camillebeland/design3/Rapport/tex/electronique.tex

\chapter{Schémas électroniques}

L'électronique est une partie importante du robot et il est important de planifier en détail les schémas électriques avant d'imprimer les PCBs. Il est a noter que le robot fonctionne avec une batterie, donc tous les symboles de mise à la terre des schémas du robots font en fait référence au 0V de la batterie.

\input{tex/electronique_alim.tex}
\input{tex/electronique_asservissement.tex}
\input{tex/electronique_induction.tex}
\input{tex/electronique_electroaimant.tex}
\input{tex/electronique_prehenseur.tex}
\input{tex/electronique_manschester.tex}
