camillebeland/design3/Rapport/tex/electronique_induction.tex

\section{Induction}

Le circuit représenté à la figure \ref{fig:induction} sert à induire un maximum de puissance au circuit de l'actionneur.
Un signal PWM est envoyé à partir du arduino de la station de base, ce dernier est amplifié par l'étage de puissance formé par les transistors.

\begin{figure}[ht]
  \centering
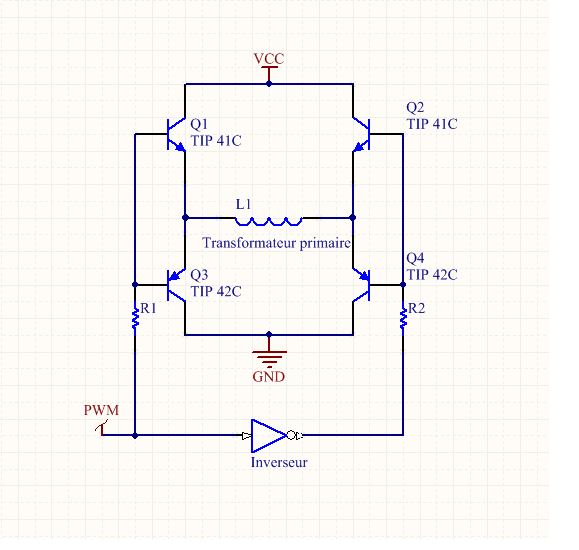
[picture p1: Rapport/resources/induction.png]
  
  \caption{Schéma électronique du circuit d'induction}
  \label{fig:induction}
\end{figure}
