camillebeland/design3/Rapport/tex/electronique_prehenseur.tex

\section{Préhenseur}

Un préhenseur est requis afin de soulever le trésor et l'amener à destination.
Afin d'économiser la charge du condensateur, il faut miniser le temps où l'électroaimant est allumé.
Il est donc optimal de soulever le trésor à l'horizontal, dans une position où il repose sur une surface plate.

Pour ce faire, le préhenseur est constitué d'un arbre entraîné par un servo-moteur contrôllé par le pololu,
comme on peut voir sur la figure \ref{fig:lift_down}.
L'électroaimant destiné à prendre le trésor est fixé au milieu de l'arbre.
Lorsqu'un trésor est pris par le préhenseur, il est soulevé puis basculé contre un muret de bois comme sur la figure \ref{fig:lift_up}.
Il est alors possible de conserver le trésor sans qu'aucune puissance ne soit consommée.

\begin{figure}[ht]
  \centering
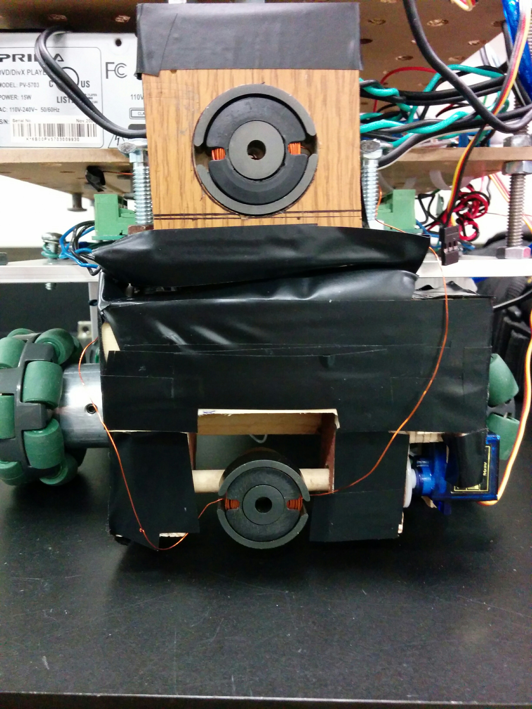
[picture p2: Rapport/resources/prehenseur_down.jpg]
  
  \caption{préhenseur en position de prise de trésor}
  \label{fig:lift_down}
\end{figure}

\begin{figure}[ht]
  \centering
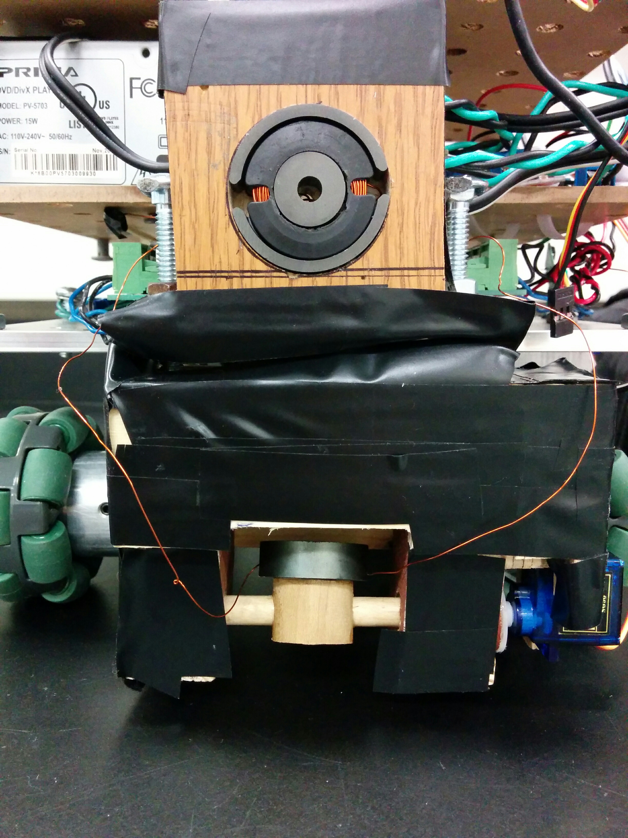
[picture p3: Rapport/resources/prehenseur_up.jpg]
  
  \caption{préhenseur en position de conservation du trésor}
  \label{fig:lift_up}
\end{figure}
