camillebeland/design3/Rapport/resources/diag_cont.pdf

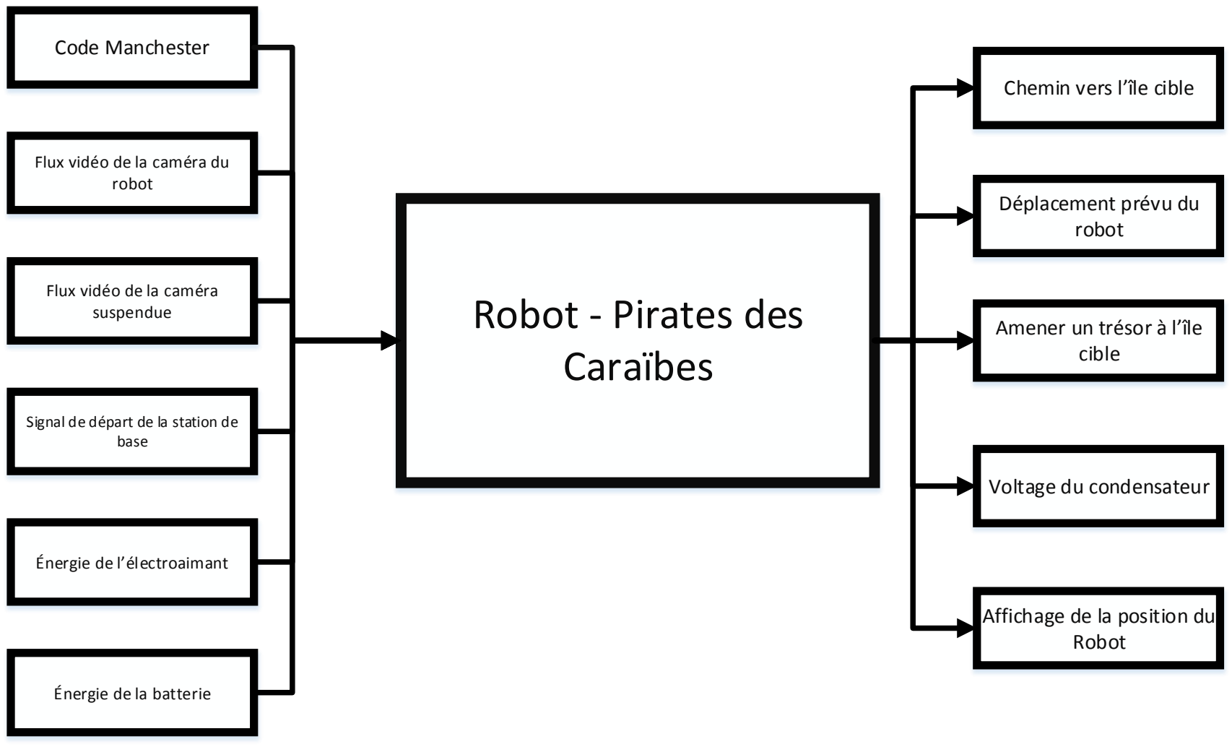
[picture p8: figure]
Robot - Pirates des Caraïbes; Code Manchester; Flux vidéo de la caméra du robot; Flux vidéo de la caméra suspendue; Signal de départ de la station de base; Énergie de l’électroaimant; Chemin vers l’île cible; Déplacement prévu du robot; Amener un trésor à l’île cible; Voltage du condensateur; Affichage de la position du Robot; Énergie de la batterie
