camillebeland/design3/Rapport/tex/bilan.tex

\chapter{Bilan post-mortem}
 
Lors d'un projet d'envergure comme celui de Design 3, il est important d'y jeter un regard en rétrospective et d'en retirer des leçons. Par exemple, déterminer les points forts et les points faibles permet de réfléchir sur les choix de design effectués au cours de la session et de s'améliorer en tant qu'ingénieur.
\input{tex/bilan_forts.tex}
\input{tex/bilan_amelioration.tex}
\input{tex/bilan_refaire.tex}
