camillebeland/design3/Rapport/tex/intro.tex

\chapter{Introduction}
Le présent rapport présente le quatrième et dernier livrable du projet Pirate des caraïbes pour le cours de Design III.
Le projet consiste à développer un robot autonome capable de repérer des pièces ferromagnétiques représentant des trésors,
de les ramasser et d'aller les déposer sur l'île spécifiée au début du défi. Plusieurs disciplines du génie sont requises afin d'accomplir la tâche,
il est donc important de bien identifier les requis et d'avoir une idée structurée du problème dès le départ. Ce rapport présente donc le résultat de la décomposition technique du problème.
Il s'agit donc d'un compte-rendu de ce qui a été fait durant toute la session et d'un compte-rendu du projet.
