camillebeland/design3/Rapport/tex/diagrams.tex

\chapter{Diagrammes Logiciel}
Les prochains diagrammes ont pour but de présenter notre architecture logicielle.
Le diagramme de classes offre une vue d'ensemble sur les différentes composantes de la partie logicielle du projet. 
Les diagrammes de séquences montrent comment les différentes composantes interagissent entre elles.
Les diagrammes de séquences sont divisés en plusieurs sous-tâches du défi afin d'améliorer la lisibilité.
Les interactions sont aussi limités au classes principales afin de permettre de comprendre facilement la séquence sans trop alourdir le schéma.

\begin{landscape}
\begin{figure}
  \centering
  
  \caption{Diagramme de classes}
\end{figure}

\begin{figure}
  \centering
  
  \caption{Diagramme de séquence complet}
\end{figure}

\begin{figure}
  \centering
  
  \caption{Diagramme de séquence de la boucle de sense-compute-control lors d'un déplacement}
\end{figure}

\begin{figure}
  \centering
  
  \caption{Diagramme de séquence de recharge}
\end{figure}

\begin{figure}
  \centering
  
  \caption{Diagramme de séquence de recherche de trésor}
\end{figure}

\begin{figure}
  \centering
  
  \caption{Diagramme de séquence dépot du trésor}
\end{figure}
\end{landscape}
