camillebeland/design3/Rapport/tex/DPF.tex

\chapter{Diagramme des propriétés fonctionelles}

\begin{landscape}
\begin{figure}[h]
  \centering
  \caption{DPF}
  
\end{figure}
\end{landscape}
