camillebeland/design3/Rapport/tex/plan_integration.tex

\chapter{Plan d'intégration}

L'intégration est une partie majeure du projet.
Elle consiste à assembler et à faire fonctionner les différents sous-systèmes entre eux.
Comme il y a beaucoup de sous-systèmes, l'intégration doit être effectuée de manière méthodique, en plusieurs étapes.
Il est important de faire un plan d'intégration assez tôt pour pouvoir guider l'équipe dans une intégration structurée.
Ce plan permet de séparer l'intégration en phases et en étapes, afin d'accélérer le processus et d'avoir un maximum de temps pour les tests.

\begin{landscape}
\begin{figure}
  \centering
  
  \caption{Plan d'intégration}
\end{figure}
\end{landscape}
