camillebeland/design3/Rapport/tex/annexe_dpf.tex

\begin{landscape}
  \begin{figure}[h]
    \label{annexe_dpf}
    \centering
    
    \caption{Description des propriétés fonctionnelles}
  \end{figure}
\end{landscape}
