camillebeland/design3/Rapport/resources/gantt.pdf

Untitled Gantt Project | 3 avr. 2016
Diagramme de Gantt | 7
Nom | Date de début | Date de fin
conception préliminaire de l'AI | 14/01/16 | 30/01/16
description des cas d'utilisation | 14/01/16 | 30/01/16
diagrammes de séquences 1ere itération 14/01/16 | 30/01/16
Diagramme de classe 1ere itération | 14/01/16 | 30/01/16
Réunion 1 | 18/01/16 | 18/01/16
Réunion 2 | 25/01/16 | 25/01/16
familiarisation avec l'équpement | 14/01/16 | 30/01/16
monter le robot | 14/01/16 | 30/01/16
choix du microcontrolleur | 14/01/16 | 25/01/16
tester les roues | 26/01/16 | 30/01/16
tester l'ordinateur | 14/01/16 | 30/01/16
tester les caméras | 14/01/16 | 30/01/16
analyse des alimentations nécéssaires | 14/01/16 | 25/01/16
choix et commande de la batterie | 26/01/16 | 30/01/16
Redaction du rapport | 14/01/16 | 30/01/16
redaction de la DPF | 14/01/16 | 30/01/16
redaction du diagramme de contexte | 14/01/16 | 30/01/16
remise 1 | 31/01/16 | 31/01/16
Réunion 3 | 08/02/16 | 08/02/16
Réunion 4 | 15/02/16 | 15/02/16
Réunion 5 | 22/02/16 | 22/02/16
conception et expérimentations | 20/01/16 | 20/03/16
construction de la station de recharge | 26/01/16 | 15/02/16
construction du chassis du robot | 21/01/16 | 31/01/16
construction du prehenseur | 21/01/16 | 08/02/16
commmunication entre l'ordinateur em...20/01/16 | 28/01/16
controler la caméra embarquée | 26/01/16 | 04/02/16
faire une librairie pour le control du...26/01/16 | 04/02/16
Detecter les élements du jeu | 02/02/16 | 07/03/16
Détecter la position et l'angle du ro... 02/02/16 | 22/02/16
placer des indicateurs sur le des...02/02/16 | 22/02/16
détecter en temps réel la positio...02/02/16 | 22/02/16
Détecter les îles | 02/02/16 | 04/03/16
Détecter les trésors | 05/02/16 | 03/03/16
Détecter la station de recharge | 16/02/16 | 07/03/16
Détecter les limites de la zone de jeu 02/02/16 | 04/03/16
Acquérir et décoder un code mansches... 02/02/16 | 13/03/16
acquérir le code manschester sans fil 02/02/16 | 17/02/16
utiliser des modules RF pour co... 02/02/16 | 17/02/16
Décoder le code manschester | 18/02/16 | 22/02/16
Faire une requête serveur | 23/02/16 | 13/03/16
Trouver et manipuler un trésor | 31/01/16 | 13/03/16
Charger l'électro-aimant | 31/01/16 | 17/02/16
Mesurer la tension dans le condens... 11/02/16 | 29/02/16
Soulever et déposer un trésor à l'aid...18/02/16 | 06/03/16
Choisir un trésor en fonction de sa ... 04/03/16 | 13/03/16
Alimenter le système | 24/01/16 | 23/02/16
Protéger les différents circuits | 24/01/16 | 23/02/16
Fournir l'alimentation approprié à c... 24/01/16 | 23/02/16
Déplacer le robot | 24/01/16 | 23/02/16
Asservir les déplacements en positi... 26/01/16 | 09/02/16
Déplacer le robot en ligne droite | 10/02/16 | 23/02/16
Effectuer une rotation du robot sur ...10/02/16 | 23/02/16
Déterminer un trajet entre deux poi... 24/01/16 | 23/02/16
Choisir automatiquement la prochaine ... 24/02/16 | 20/03/16
Être prêt au jeu après la mise sous t...24/02/16 | 20/03/16
Faire toutes les étapes du jeu sans i... 28/02/16 | 20/03/16
Afficher l'état du jeu | 24/02/16 | 13/03/16
afficher la tension du condensateur 01/03/16 | 13/03/16
afficher la carte virtuelle du jeu ave... 05/03/16 | 10/03/16
Afficher les déplacements du robot ...24/02/16 | 29/02/16
Préparation à la présentation orale | 21/02/16 | 24/02/16
présentations orales d'avancement | 25/02/16 | 25/02/16
Rapport 2 | 21/02/16 | 27/02/16
registre de risques | 21/02/16 | 27/02/16
Diagramme des fonctionnalités | 21/02/16 | 27/02/16
Diagramme physique | 21/02/16 | 27/02/16
Plan de test | 21/02/16 | 27/02/16
Diagramme de classes 2e itération | 21/02/16 | 27/02/16
Diagrammes de séquences 2e itération 21/02/16 | 27/02/16
développement logiciel | 21/02/16 | 27/02/16
tests unitaires | 21/02/16 | 27/02/16
Plan d'intégration | 21/02/16 | 27/02/16
Avancement de la construction système 21/02/16 | 27/02/16
remise 2 | 28/02/16 | 28/02/16
Réunion 6 | 29/02/16 | 29/02/16
Réunion 7 | 07/03/16 | 07/03/16
Réunion 8 | 14/03/16 | 14/03/16
Réunion 9 | 21/03/16 | 21/03/16
Réunion 10 | 28/03/16 | 28/03/16
Integration | 29/02/16 | 02/04/16
phase 1 | 29/02/16 | 03/03/16
phase 2 | 04/03/16 | 11/03/16
phase 3 | 12/03/16 | 18/03/16
phase 4 | 21/03/16 | 02/04/16
Tests selon la matrice de tests | 29/02/16 | 07/04/16
demonstrations | 31/03/16 | 31/03/16
Rapport 3 | 30/03/16 | 02/04/16
Registre de risques corrigé | 30/03/16 | 02/04/16
Diagramme de classes | 30/03/16 | 02/04/16
Diagrammes de séquence 3e itération | 30/03/16 | 02/04/16
Explication des algorithmes de vision ut...30/03/16 | 02/04/16
schémas électroniques | 30/03/16 | 02/04/16
Plan d'intégration corrigé | 30/03/16 | 02/04/16
DPF 3e itération | 30/03/16 | 02/04/16
remise 3 | 03/04/16 | 03/04/16
Temps de réserve pour terminer le robot | 02/04/16 | 07/04/16
Tests de robustesse finaux et raffinage | 08/04/16 | 13/04/16
Réunion 11 | 04/04/16 | 04/04/16
Réunion 12 | 11/04/16 | 11/04/16
competition | 14/04/16 | 14/04/16
remise 4 | 17/04/16 | 17/04/16

2016

Semaine 2 | Semaine 3 | Semaine 4 | Semaine 5 | Semaine 6 | Semaine 7 | Semaine 8 | Semaine 9 | Semaine 10 | Semaine 11 | Semaine 12 | Semaine 13 | Semaine 14 | Semaine 15 | Semaine 16
11/01/16 | 18/01/16 | 25/01/16 | 01/02/16 | 08/02/16 | 15/02/16 | 22/02/16 | 29/02/16 | 07/03/16 | 14/03/16 | 21/03/16 | 28/03/16 | 04/04/16 | 11/04/16 | 18/04/16
Réunion 1 Réunion 2 remise 1 | Réunion 3 Réunion 4 Réunion 5 présentations orales d'avancement remise 2 Réunion 6 Réunion 7 Réunion 8 Réunion 9 Réunion 10 demonstrations remise 3 Réunion 11 Réunion 12 competition remise 4
