camillebeland/design3/base_station/mock_image_worst_case.jpg

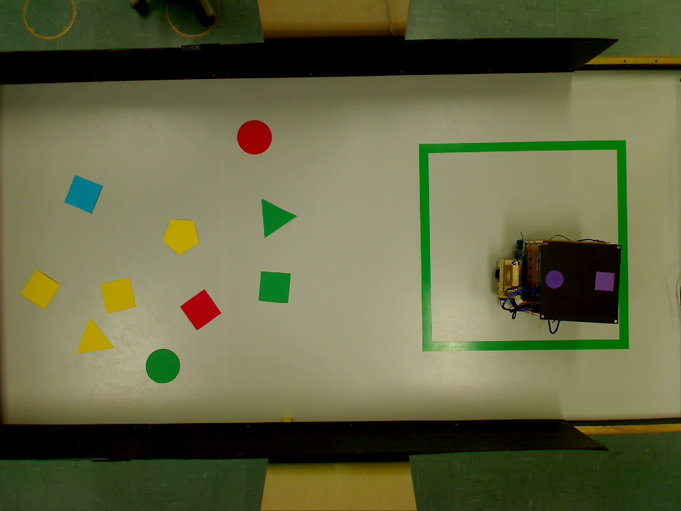
base_station/mock_image_worst_case.jpg
