camillebeland/design3/base_station/vision/mock_image.jpg

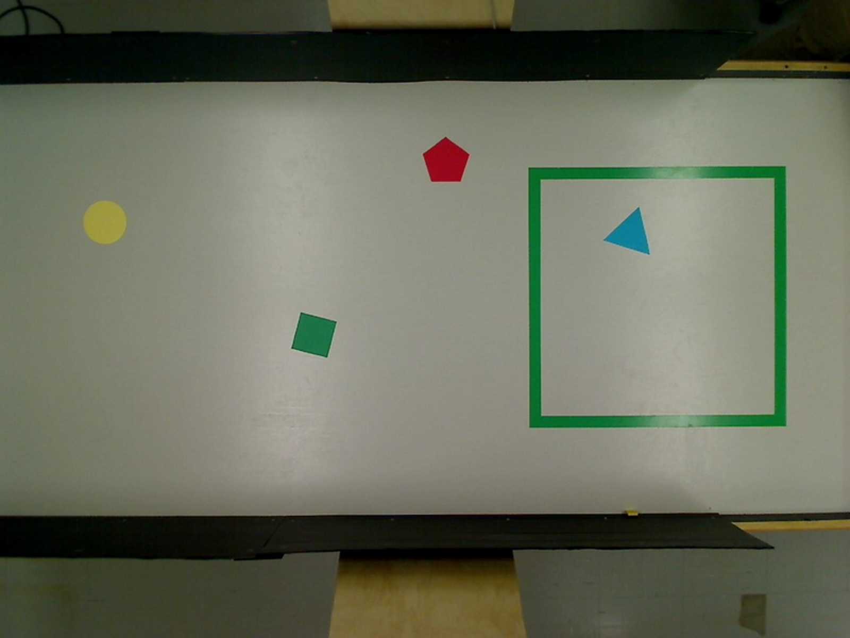
base_station/vision/mock_image.jpg
