camillebeland/design3/Rapport/resources/induction.jpg

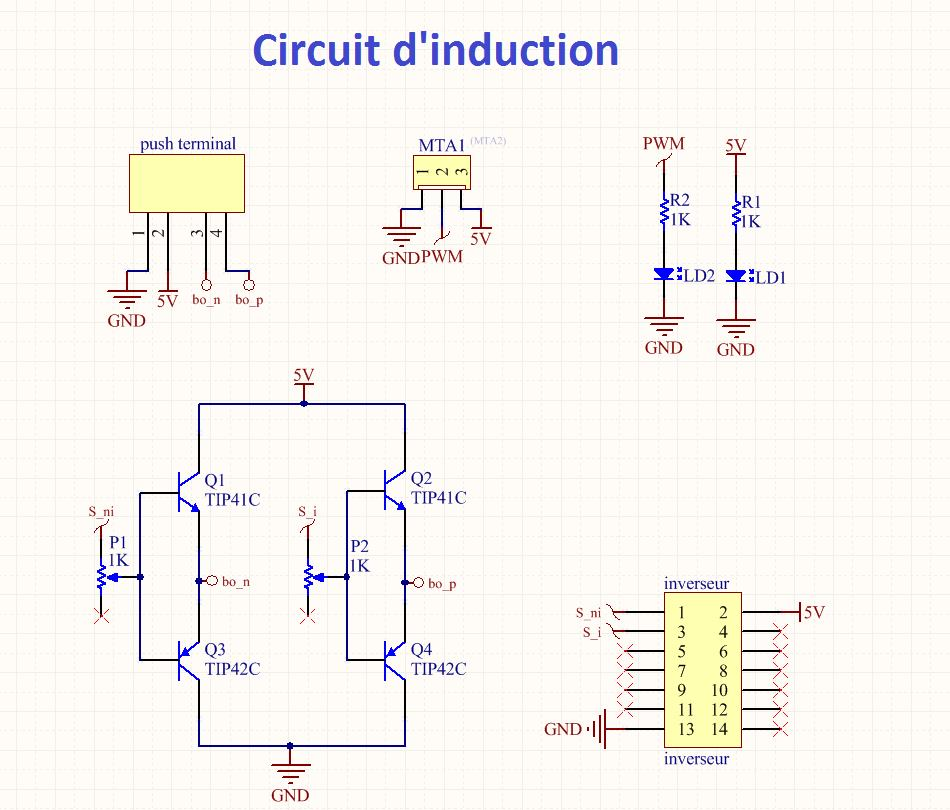
Rapport/resources/induction.jpg
