camillebeland/design3/Rapport/resources/regu_analog.jpg

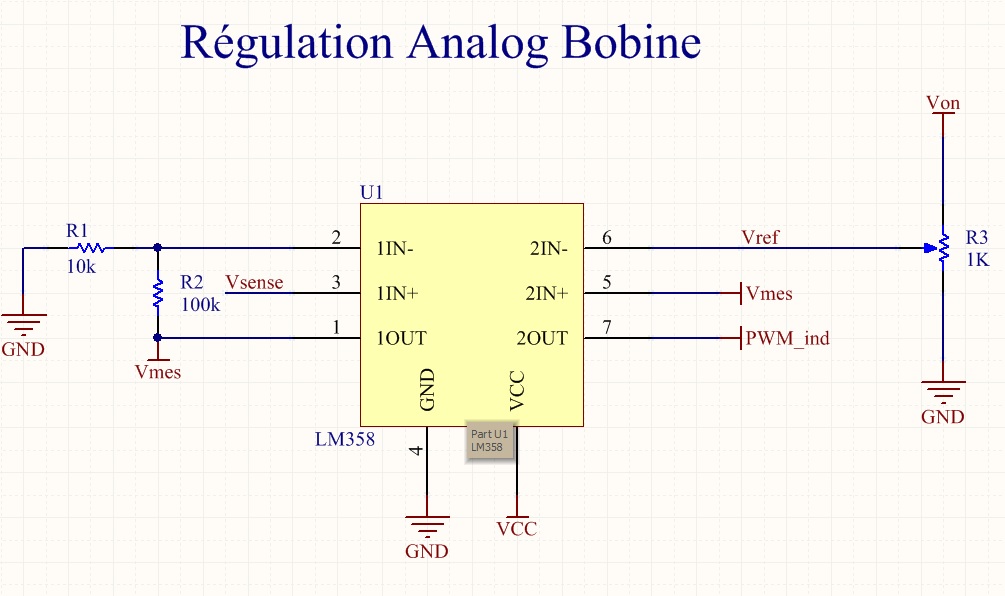
Rapport/resources/regu_analog.jpg
