camillebeland/design3/vision_utils/embedded_treasures.jpg

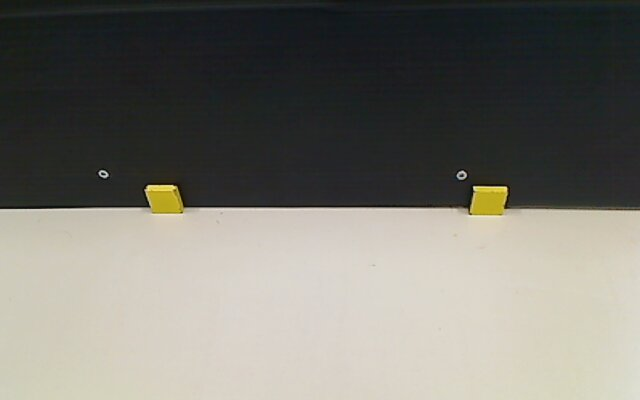
vision_utils/embedded_treasures.jpg
