camillebeland/design3/vision_utils/mock_image.jpg

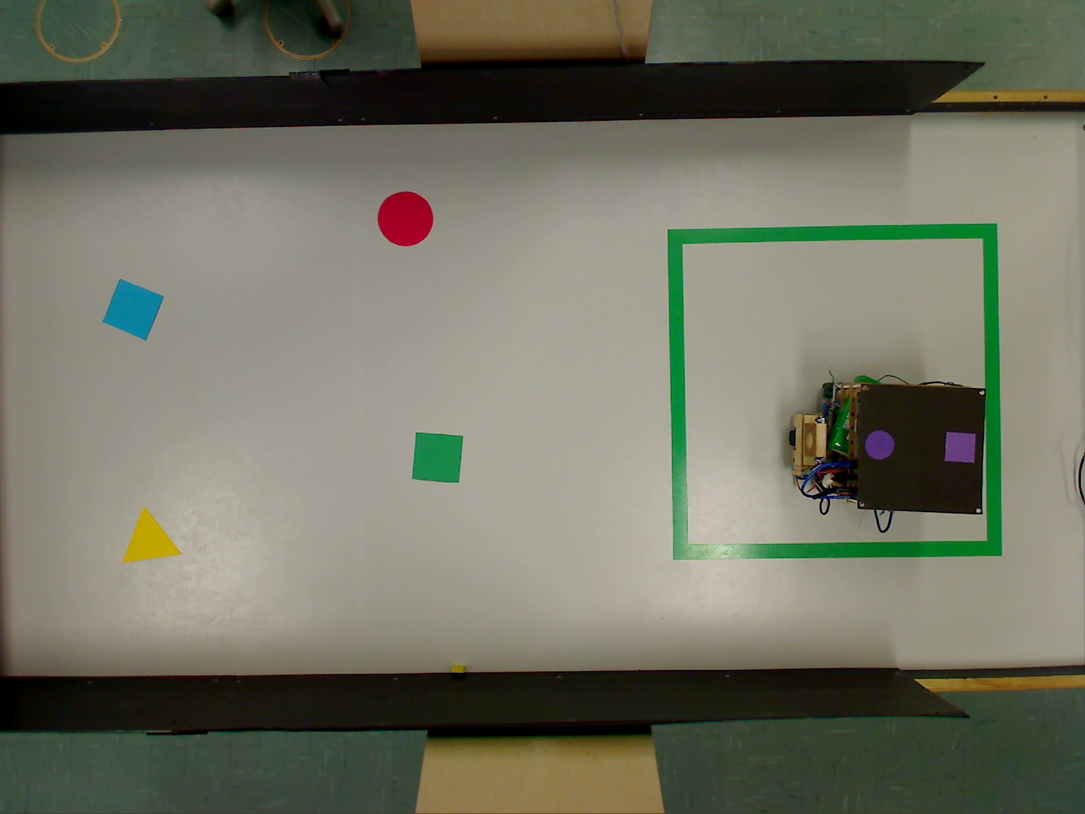
vision_utils/mock_image.jpg
