camillebeland/design3/vision_utils/photo_robot_mauve.jpg

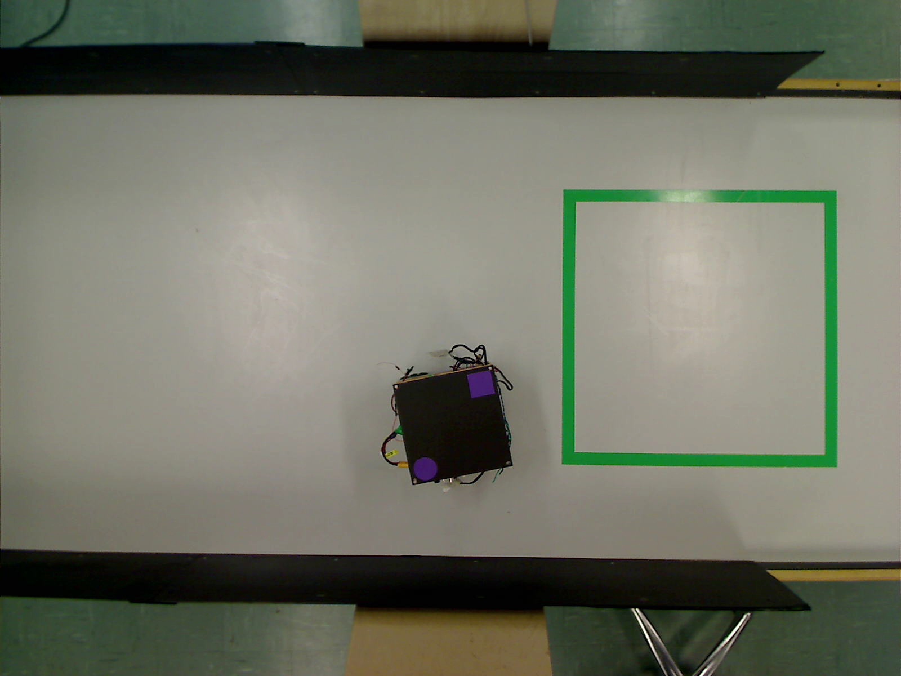
vision_utils/photo_robot_mauve.jpg
