camillebeland/design3/Rapport/tex/tests_unitaires.tex

\chapter{Tests unitaires}

Voir le code source.
Les test peuvent être exécutés à l'aide de nosetests.
Pour le coverage, utiliser la commande "nosetests --with-coverage"
