camillebeland/design3/Rapport/resources/alim.pdf

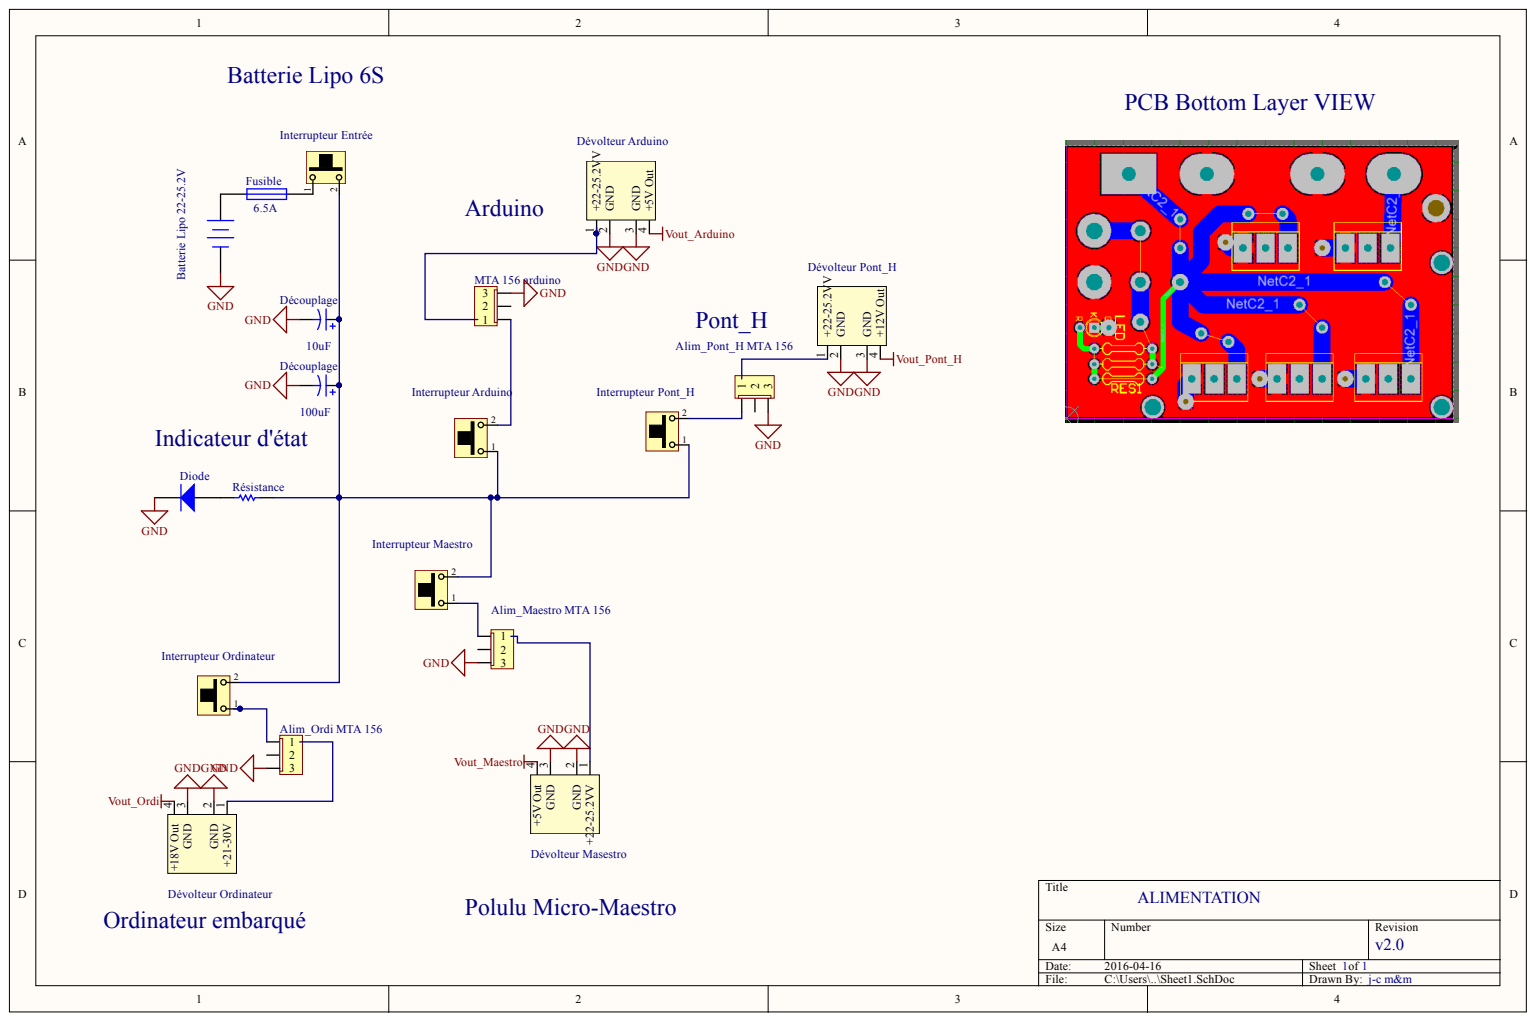
[picture p18: page 1]

PCB Bottom Layer VIEW

GND 3 +5V Out 4 Dévolteur Masestro

GND 3 +18V Out 4 Dévolteur Ordinateur
