camillebeland/design3/Rapport/resources/shield.pdf

SCL | 1 SDA | 2 RX1 | 3 TX 1 | 4 RX2 | 5 TX 2 | 6 RX3 | 7 TX 3 | 8
5v | 1 5v 2 | 22 | 3 23 4 | 24 | 5 25 6 | 26 | 7 27 8 | 28 | 9 29 10 | 30 | 11 31 12 | 32 | 13 33 14 | 34 | 15 35 16 | 36 | 17 37 18 | 38 | 19 39 20 | 40 | 21 41 22 | 42 | 23 43 24 | 44 | 25 45 26 | 46 | 27 47 28 | 48 | 29 49 30 | 50 | 31 51 32 | 52 | 33 53 34 | 0v | 35 0v 36

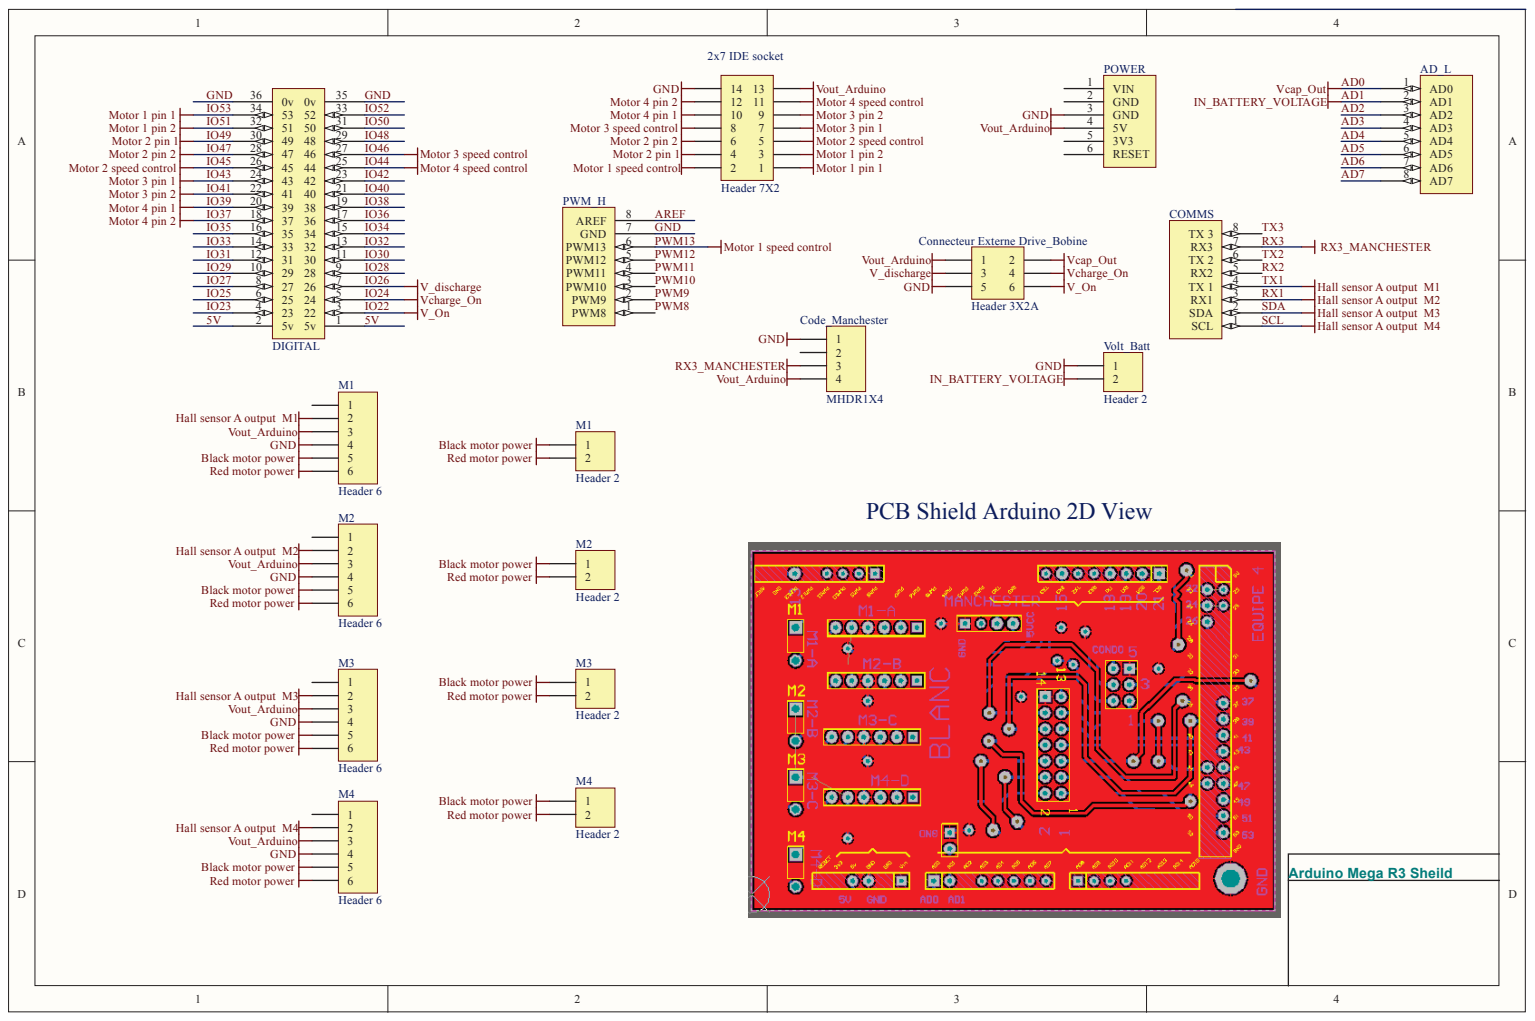
[picture p19: page 1]
PWM8; PWM9; PWM10; PWM11; PWM12; PWM13; GND; AREF; SDA SCL; VIN 1; GND 2; GND 3 5V 4 3V3 5 RESET 6; POWER; COMMS; 1 PWM9; 2 PWM10; 3 PWM11; 4 PWM12; 5 PWM13; 6 GND; 7 AREF; PWM_H; DIGITAL; 2x7 IDE socket; Header 7X2; Header 6; Header 2; Motor 2 pin 1; Motor 2 pin 2; Motor 4 pin 1; Motor 4 pin 2; Motor 1 pin 1 Motor 1 pin 2 Motor 2 pin 1 Motor 2 pin 2; Motor 3 pin 1 Motor 3 pin 2 Motor 4 pin 1 Motor 4 pin 2; Vout_Arduino; Connecteur Externe Drive_Bobine; Header 3X2A; Volt_Batt; Code_Manchester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

Vout_Arduino
Motor 4 speed control
Motor 3 pin 2
Motor 3 pin 1
Motor 2 speed control
Motor 1 pin 2
Motor 1 pin 1

Motor 3 speed control

Motor 1 speed control

Hall sensor A output M1
Hall sensor A output M2
Hall sensor A output M3
Hall sensor A output M4

Black motor power
Red motor power

PCB Shield Arduino 2D View

Arduino Mega R3 Sheild
