camillebeland/design3/Rapport/pdf/UL_P.pdf

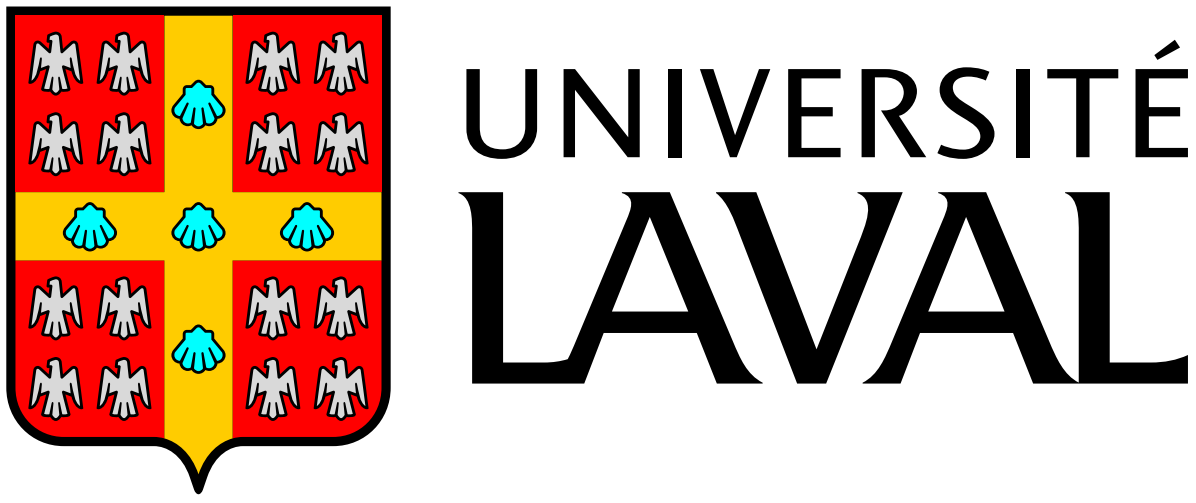
[picture p20: page 1]
