camillebeland/design3/Rapport/resources/diag_fonc.pdf

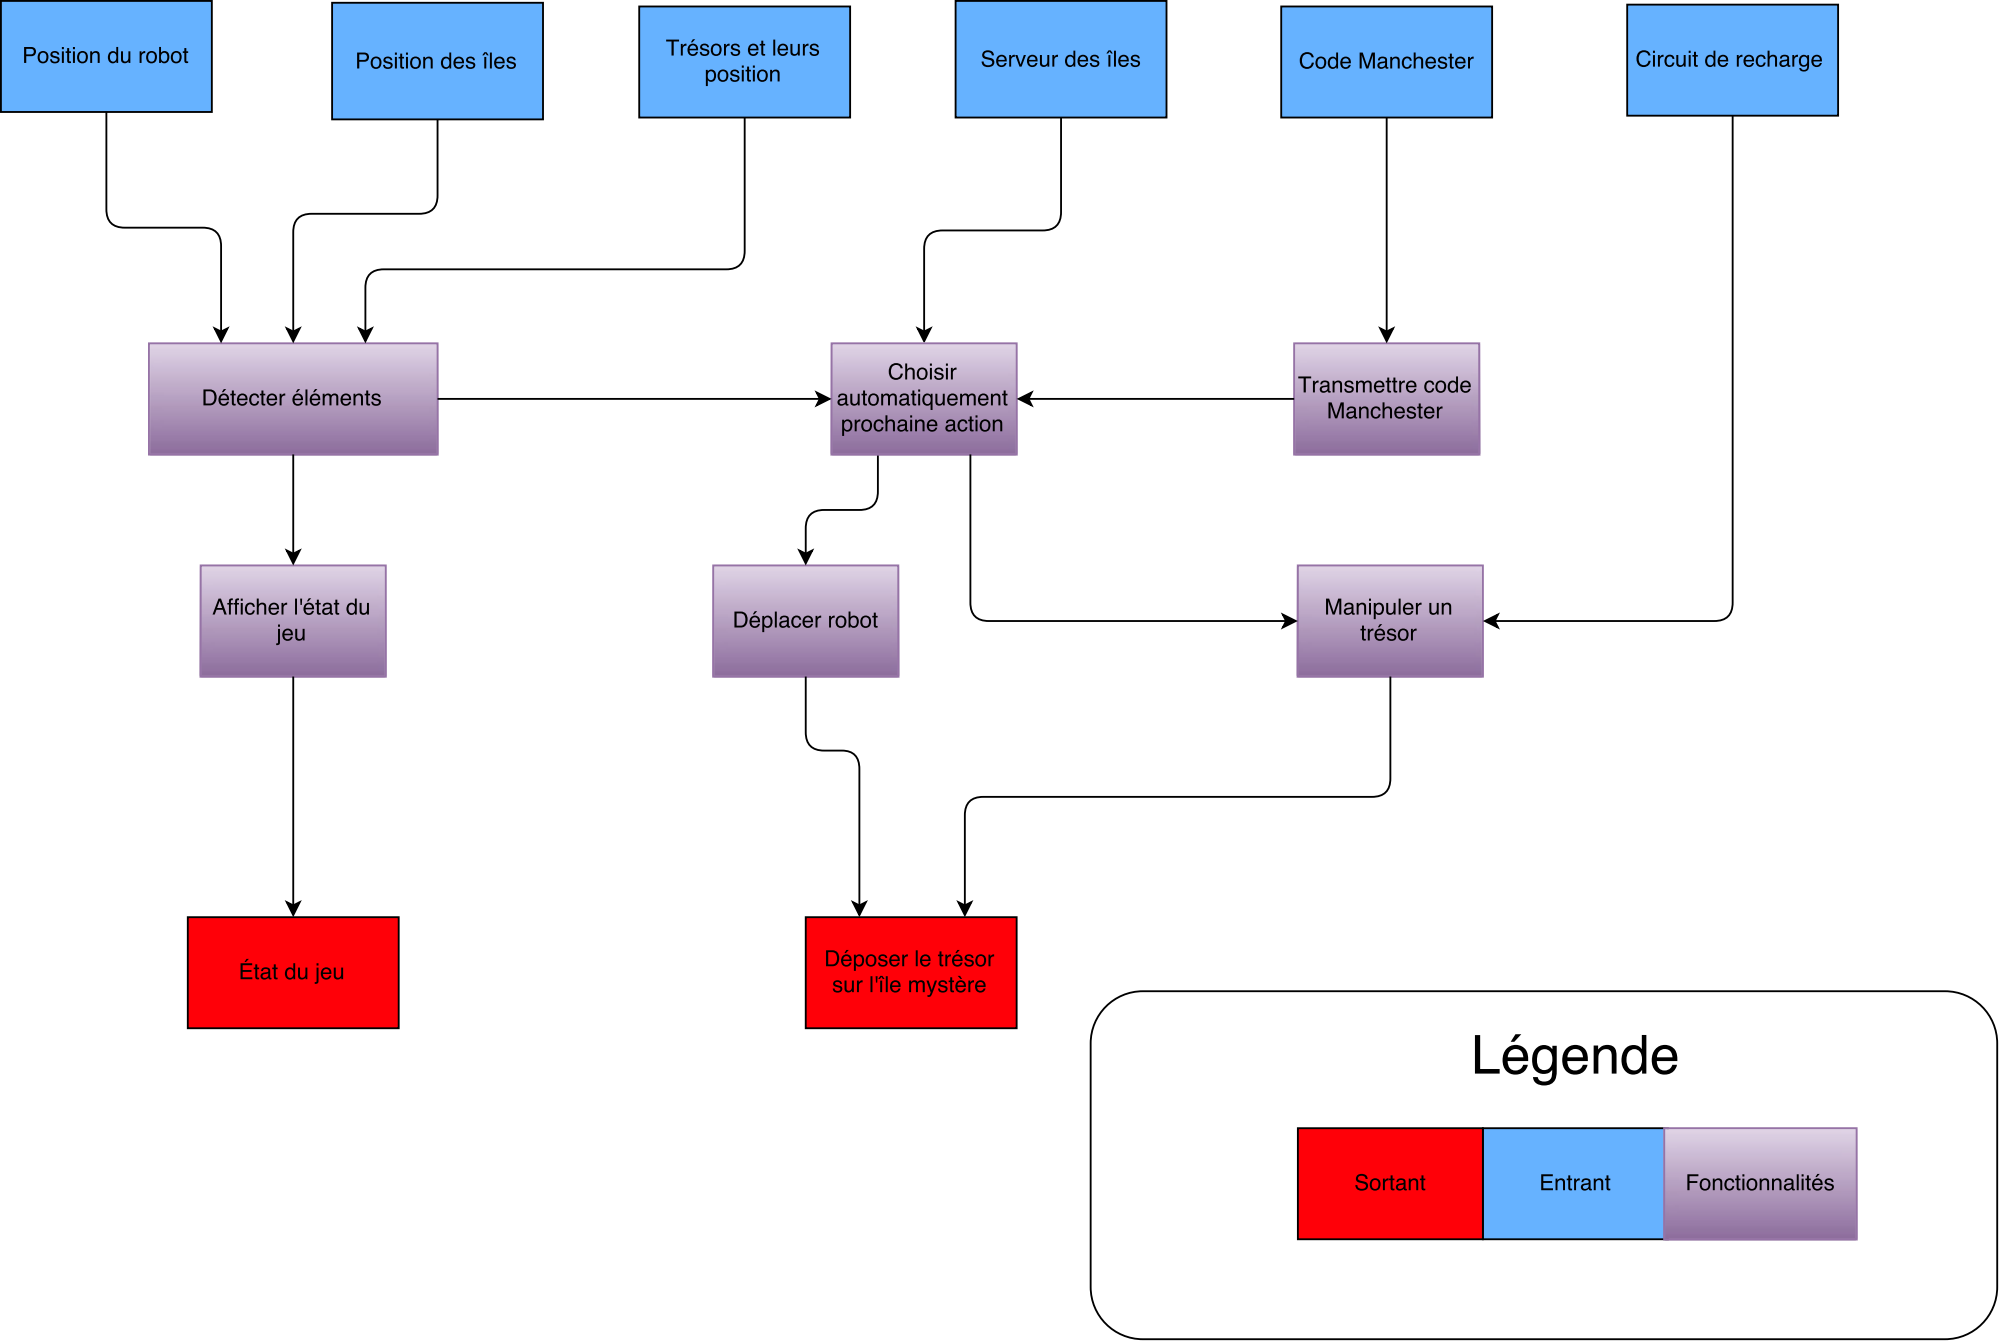
[picture p21: page 1]
