camillebeland/design3/Rapport/resources/diagrams/classDiagram.pdf

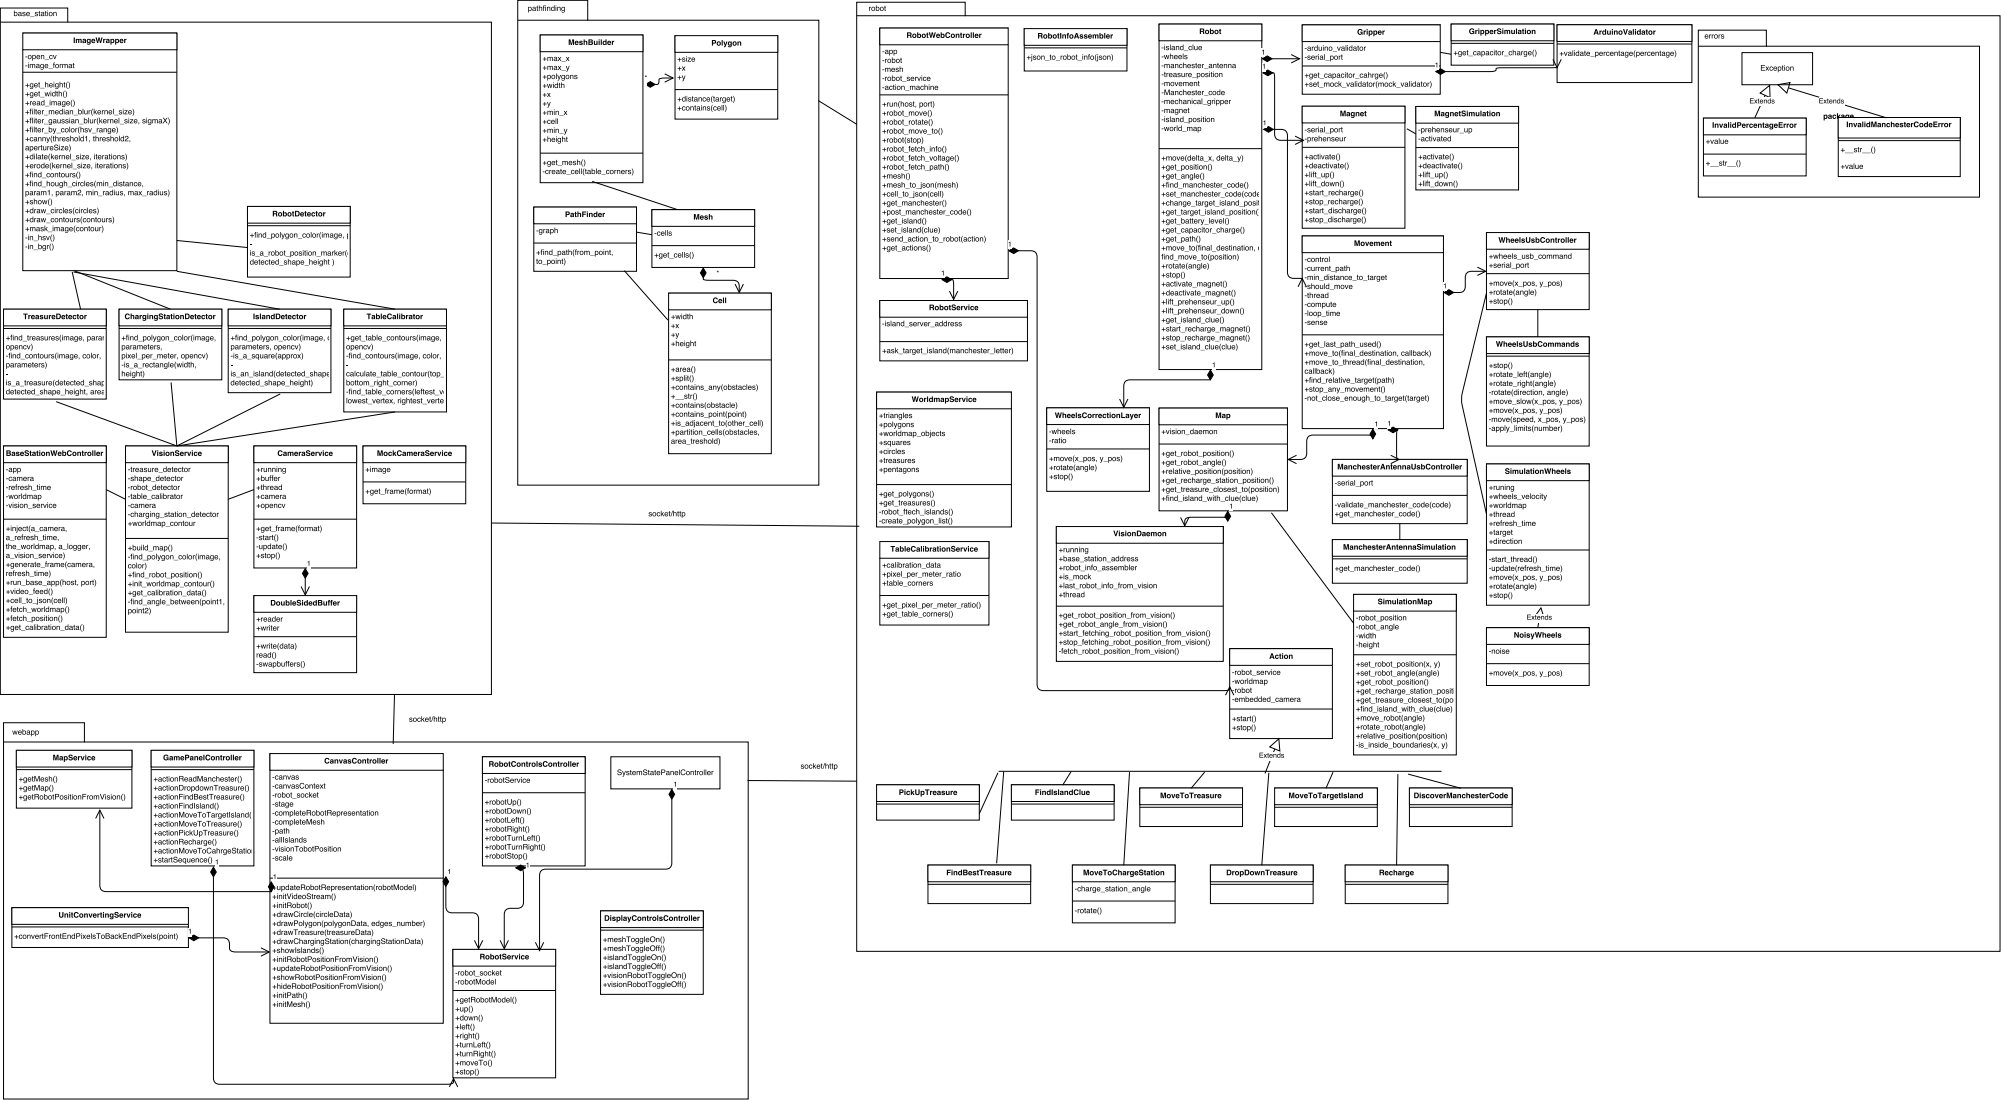
[picture p22: page 1]
