camillebeland/design3/Rapport/resources/diagrams/depositAction.pdf

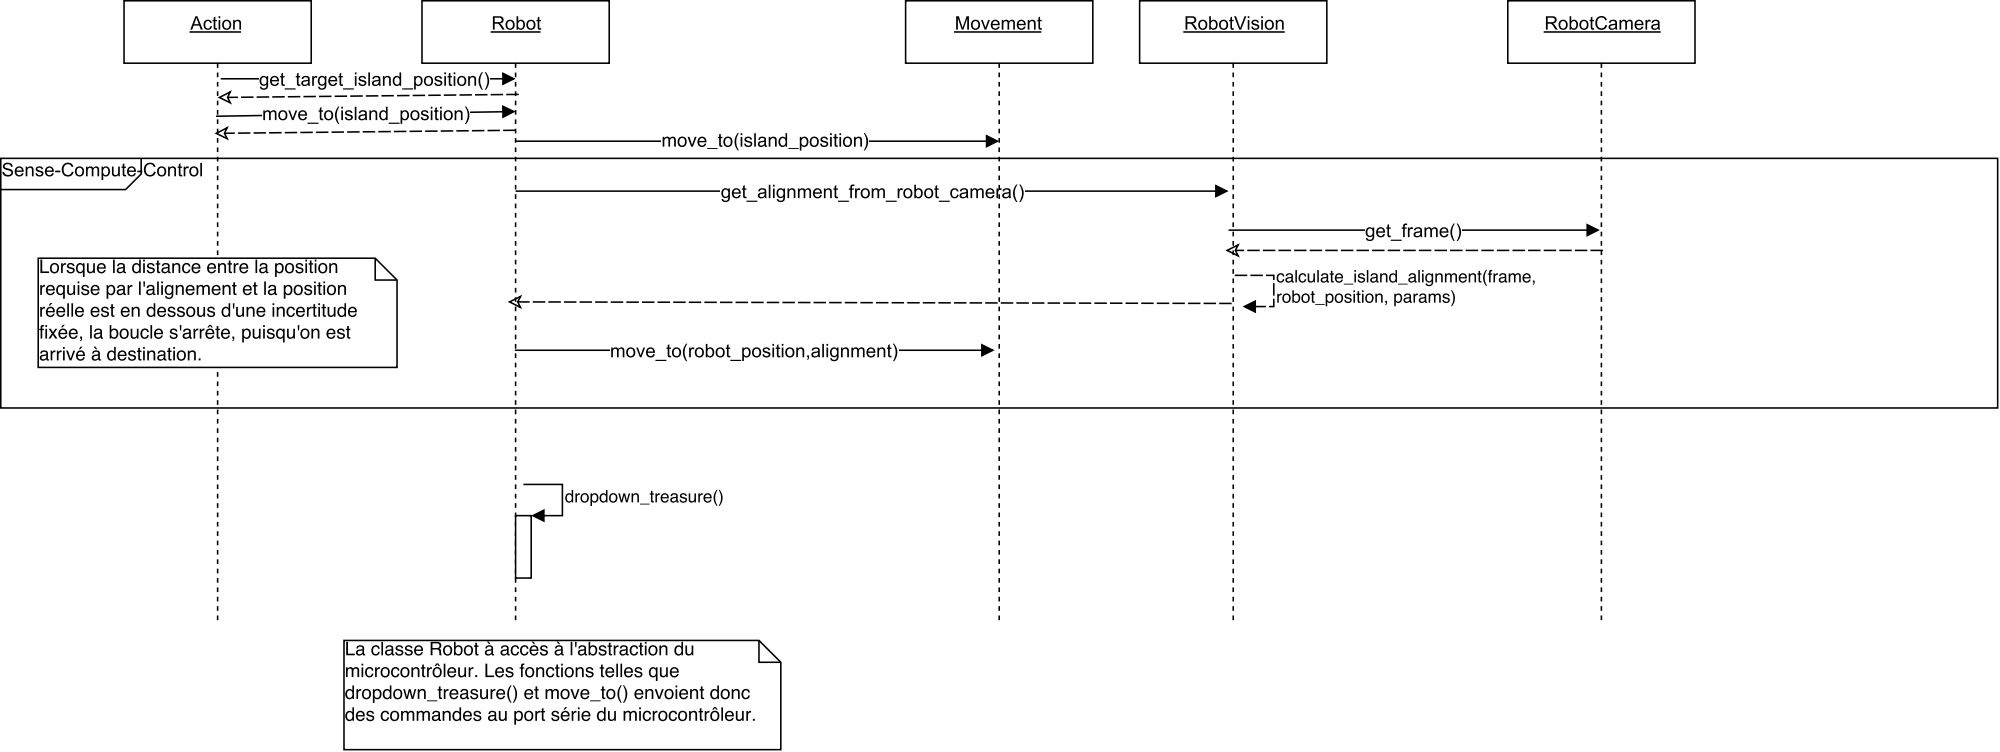
[picture p23: page 1]
