camillebeland/design3/Rapport/resources/diagrams/findTreasureAction.pdf

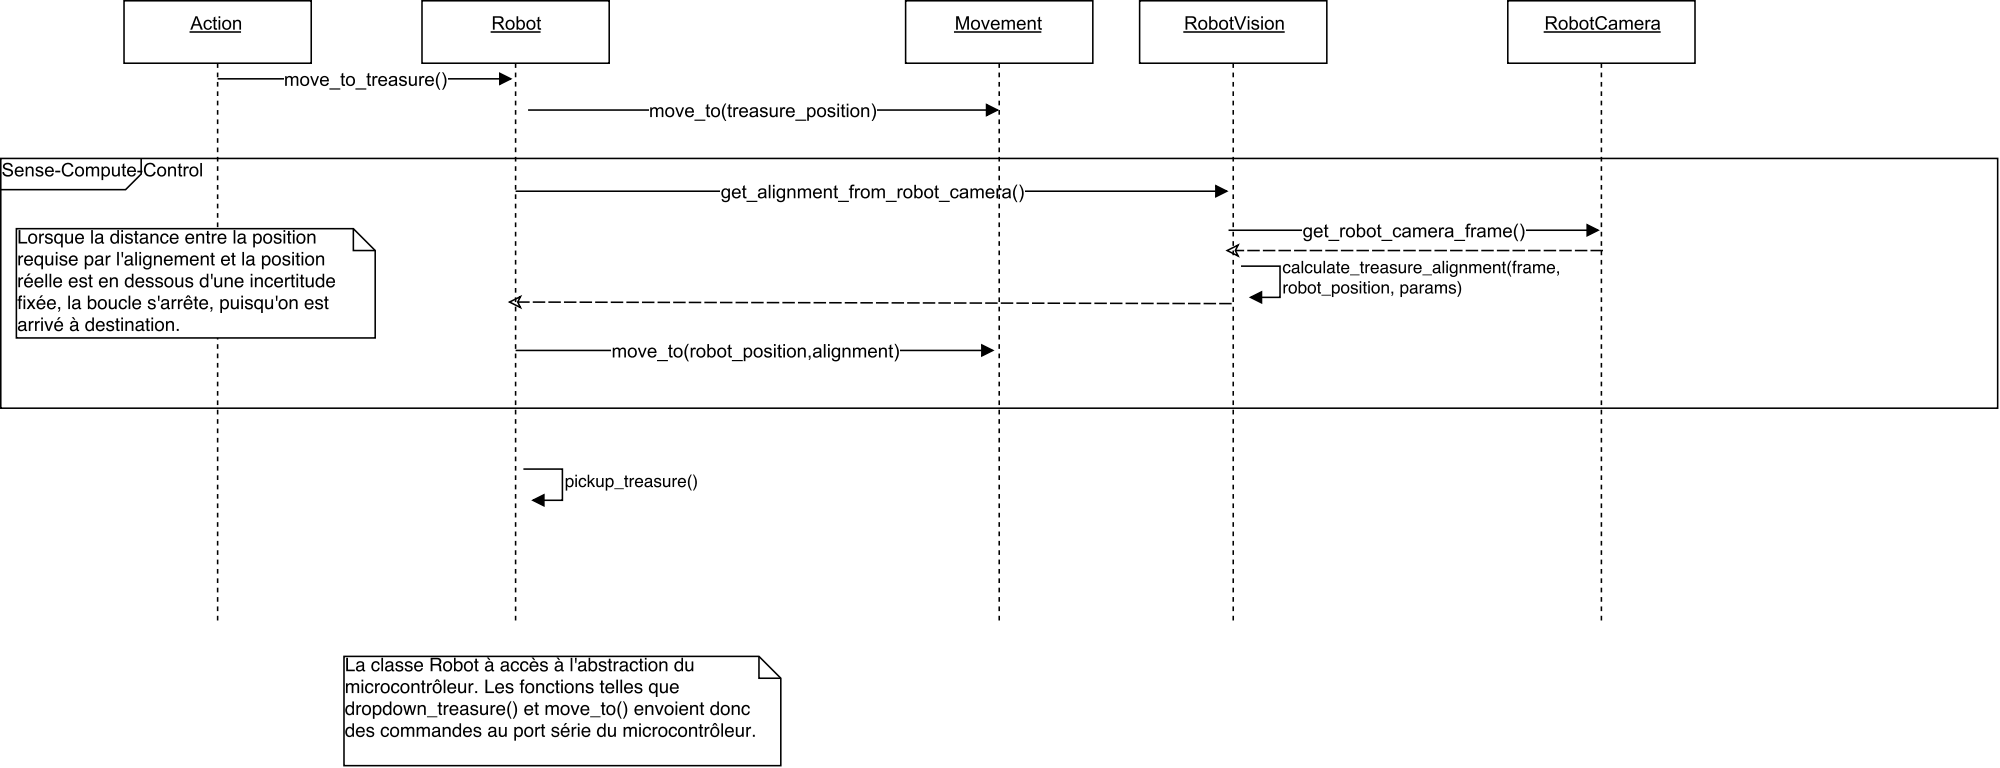
[picture p24: page 1]
