camillebeland/design3/Rapport/resources/diagrams/rechargeAction.pdf

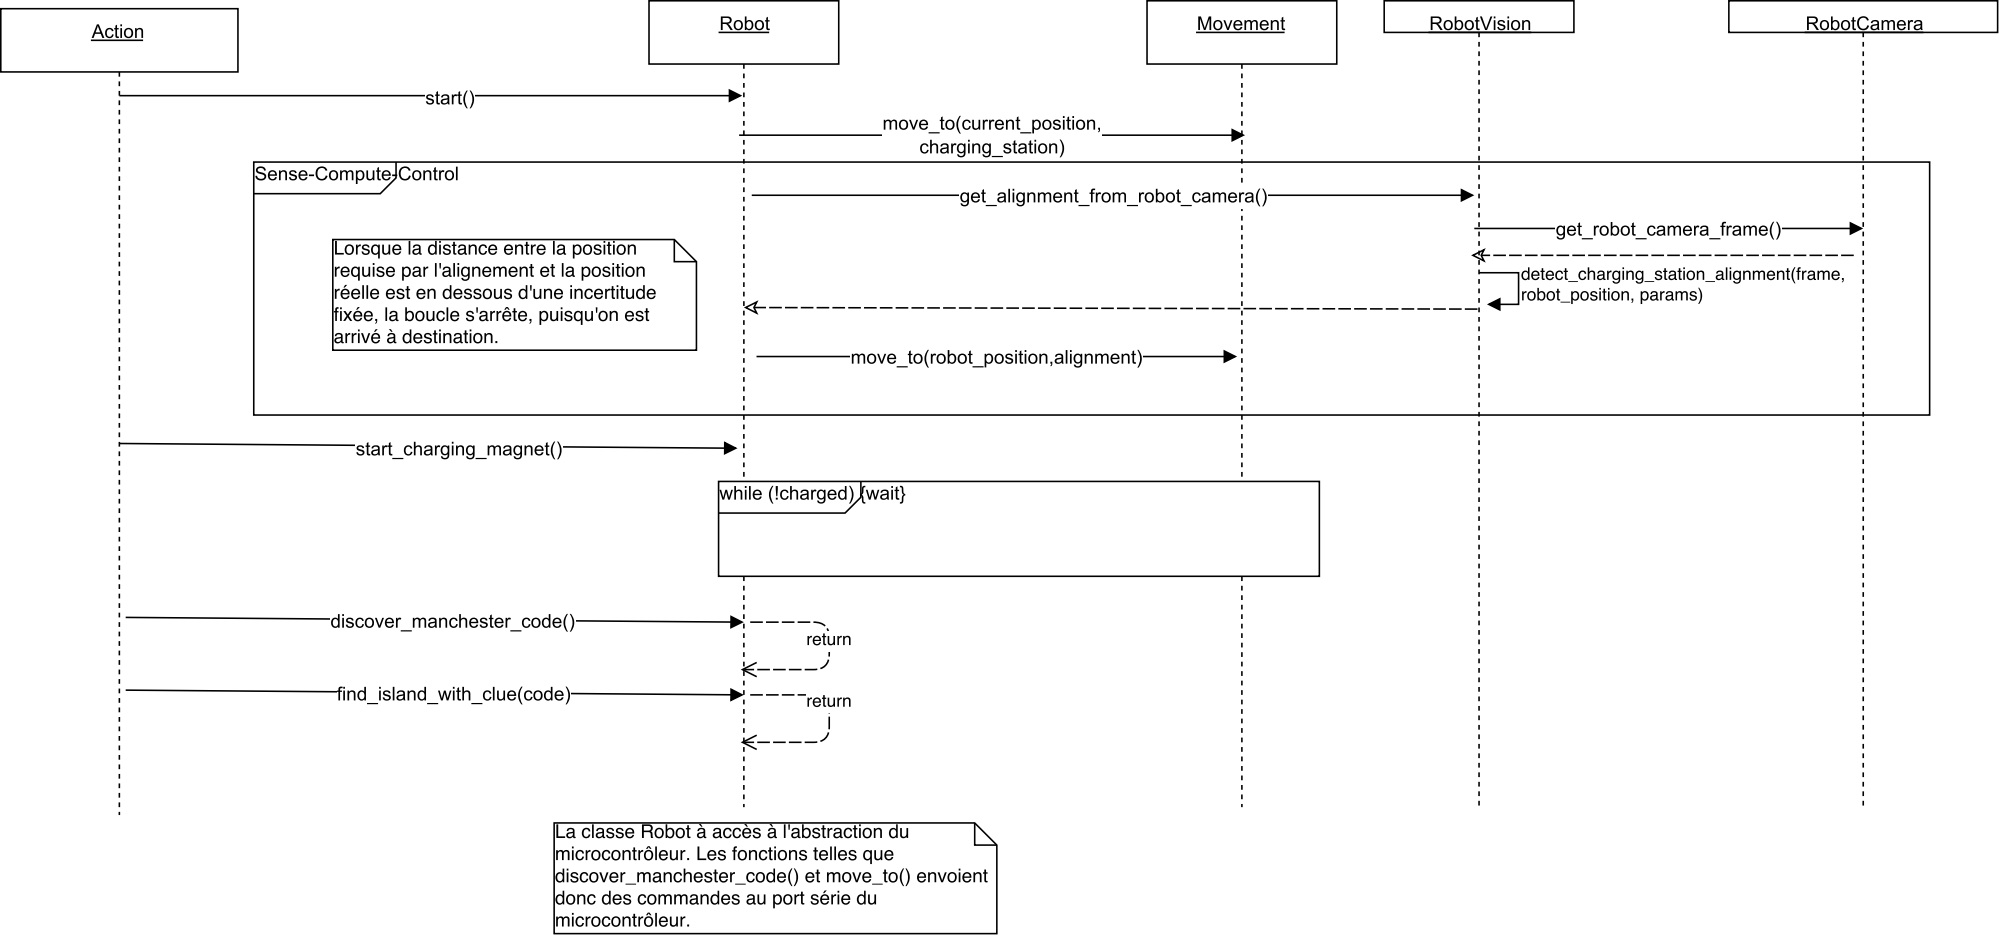
[picture p25: page 1]
