camillebeland/design3/Rapport/resources/diagrams/robotMovement.pdf

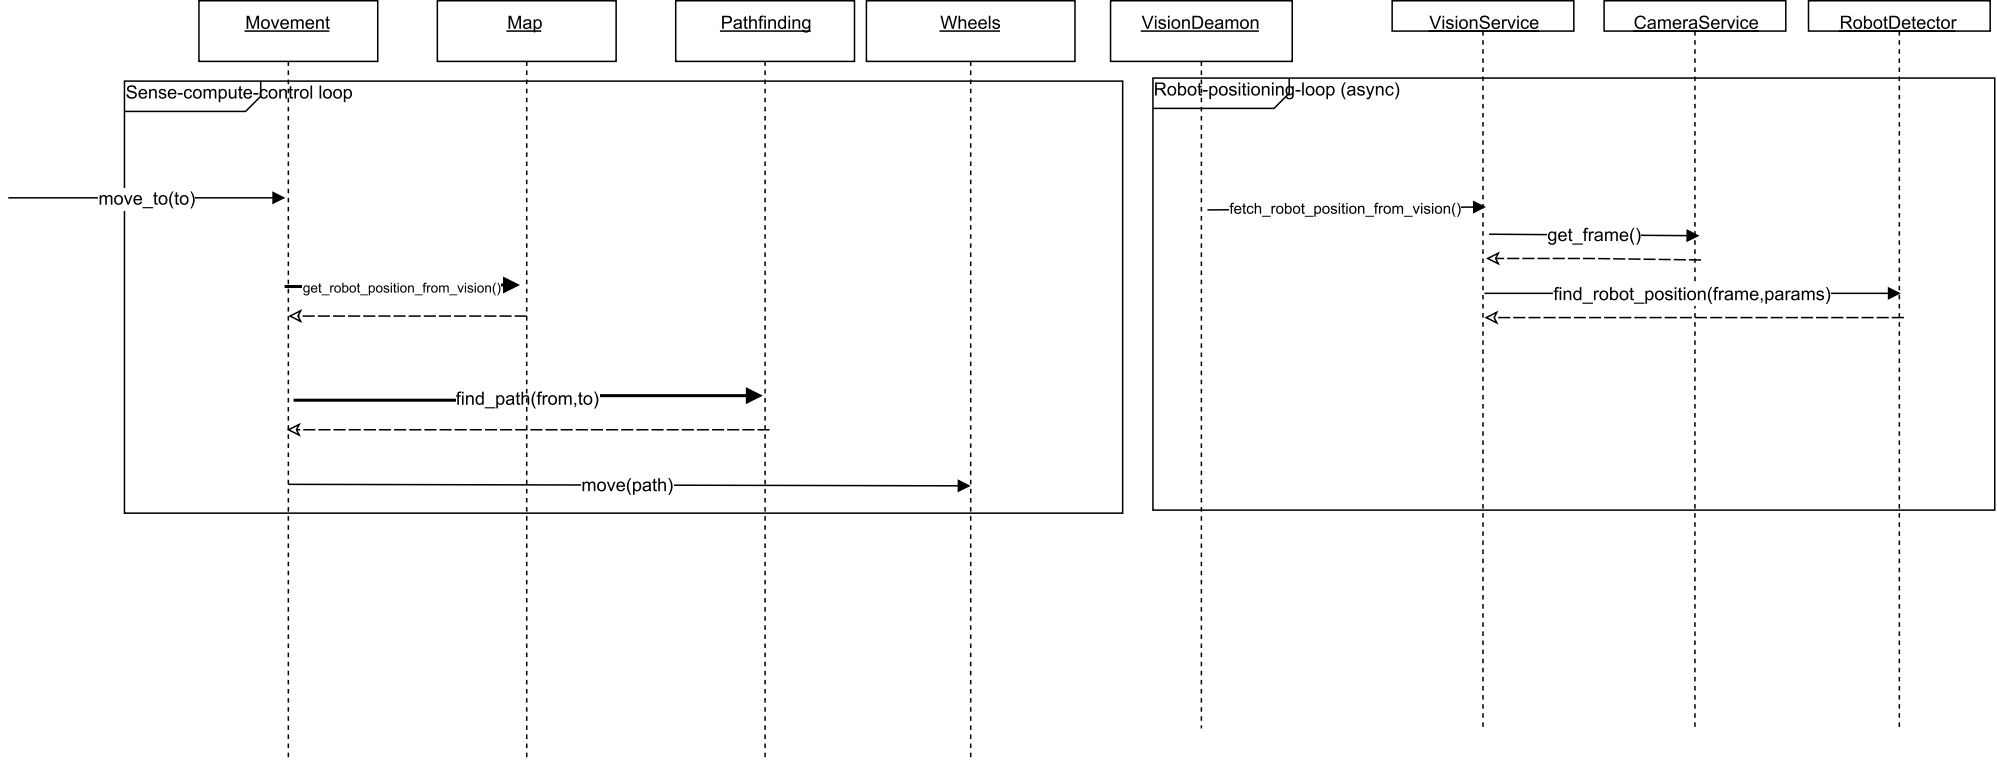
[picture p26: page 1]
