camillebeland/design3/Rapport/resources/diagrams/sequenceDiagram.pdf

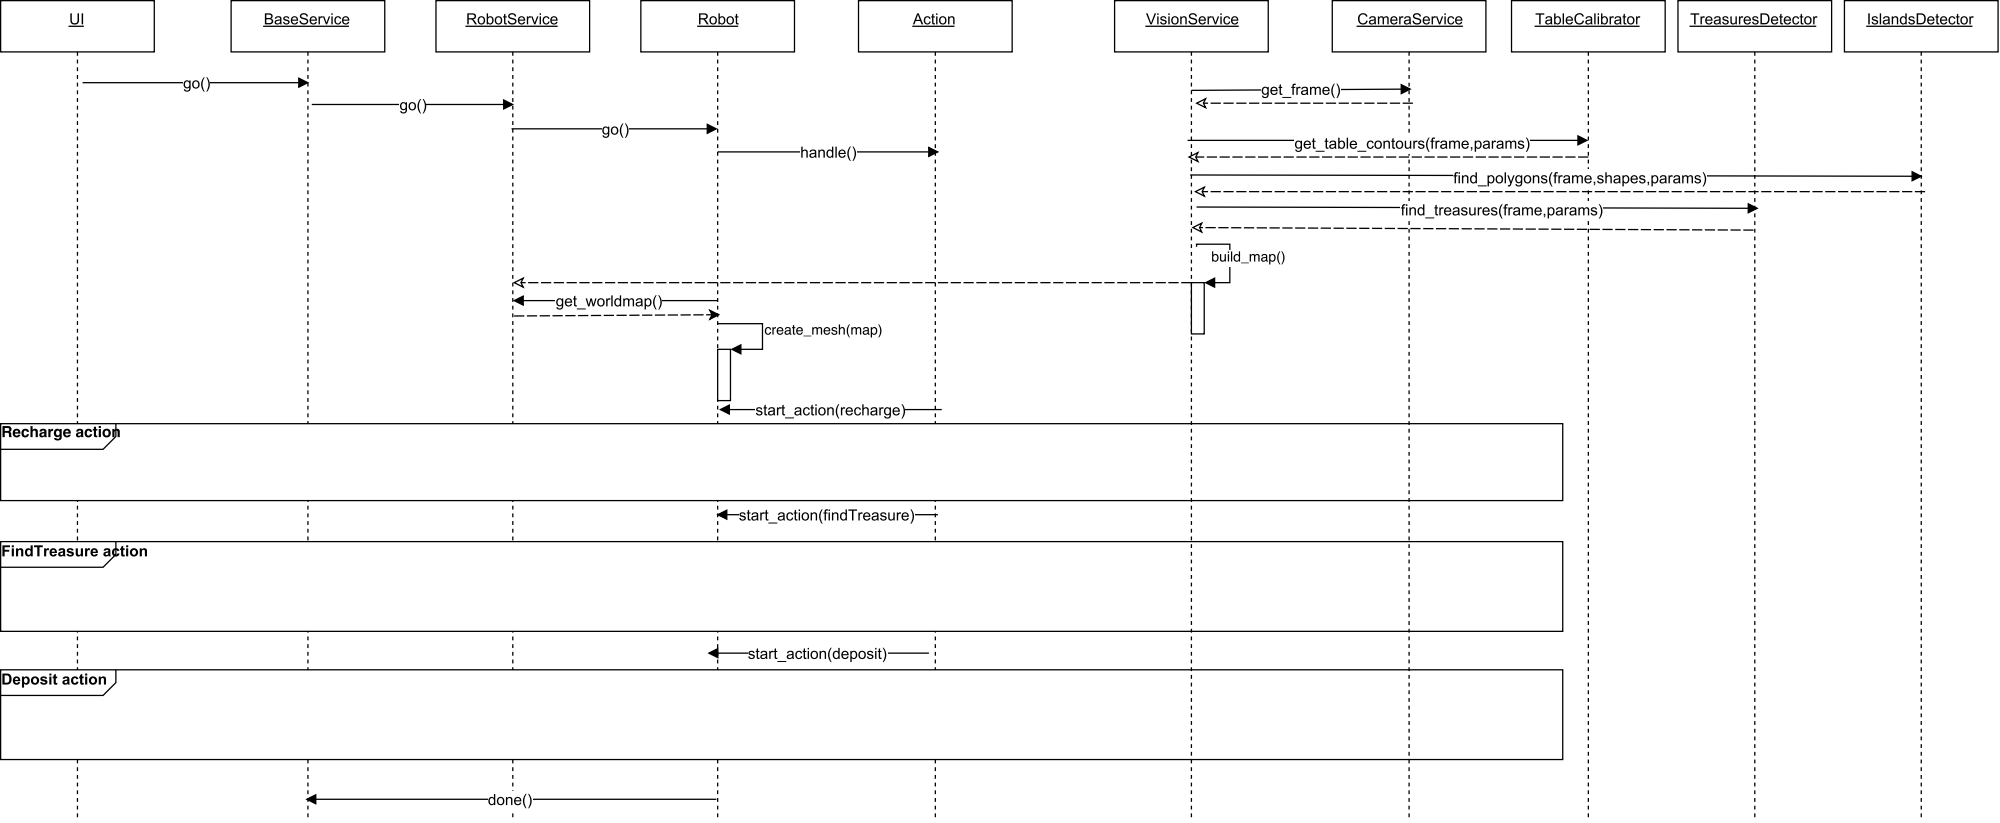
[picture p27: page 1]
