camillebeland/design3/robot_app.py

import serial
import time
import serial.tools.list_ports as lp
from configuration import configuration
from robot import robot_web_controller
from robot.assemblers.robot_info_assembler import RobotInfoAssembler
from robot.manchester_antenna_usb_controller import ManchesterAntennaUsbController
from robot.battery import Battery
from robot.map import Map
from robot.vision_perspective_correction import VisionPerspectiveCorrection
from robot.robot import Robot
from robot.robot_service import RobotService
from robot.simulation.robot_service_simulation import RobotServiceSimulation
from robot.simulation.error_simulation import NoisyWheels
from robot.simulation.manchester_antenna_simulation import ManchesterAntennaSimulation
from robot.simulation.battery_simulation import BatterySimulation
from robot.simulation.simulation_map import SimulationMap
from robot.wheels_usb_commands import WheelsUsbCommands
from robot.wheels_usb_controller import WheelsUsbController
from robot.wheels_correction_layer import WheelsCorrectionLayer
from robot.worldmap_service import WorldmapService
from robot.action_machine import ActionMachine
from robot.context import Context
from robot.actions.refresh_image import RefreshImageAction
from robot.actions.move_to_charge_station import MoveToChargeStationAction
from robot.actions.pick_up_treasure import PickUpTreasureAction
from robot.actions.drop_down_treasure import DropDownTreasure
from robot.actions.recharge import RechargeAction
from robot.actions.discover_manchester_code import DiscoverManchesterCodeAction
from robot.actions.find_island_clue import FindIslandClue
from robot.actions.end_sequence import EndSequenceAction
from robot.actions.find_best_treasure import FindBestTreasureAction
from robot.actions.find_island import FindIslandAction
from robot.actions.move_to_target_island import MoveToTargetIslandAction
from robot.actions.move_to_treasure import MoveToTreasureAction
from robot.actions.start_timer import StartTimerAction
from robot.vision_daemon import VisionDaemon
from robot.actions.scan_treasures import ScanTreasuresAction
from robot.movement import Movement
from robot.magnet import Magnet
from robot.simulation.magnet_simulation import MagnetSimulation
from maestro_control.prehenseur_rotation_control import PrehenseurRotationControl
from robot.vision_refresher import VisionRefresher
from vision_utils.camera_service import CameraService
from vision_utils.mock_camera_service import MockCameraService
from robot.vision.embedded_vision_service import EmbeddedVisionService
from robot.vision.embedded_treasure_detector import EmbeddedTreasureDetector
from robot.vision.embedded_recharge_station_detector import EmbeddedRechargeStationDetector
from robot.table_calibration_service import TableCalibrationService
from robot.actions.align_with_treasure import AlignWithTreasureAction
from robot.actions.align_with_charging_station_action import AlignWithChargingStationAction
from maestro_control.camera_rotation_control import CameraRotationControl
import cv2
from robot.treasure_easiest_path import TreasureEasiestPath
from utils.position import Position
from unittest.mock import *
from vision_utils.camera_config_script import init_camera_parameters
from robot.timer import Timer

def camera_builder(camera_config, camera_id, camera_width, camera_height):
    if camera_config == "webcam":
        init_camera_parameters()
        open_cv_camera = cv2.VideoCapture(camera_id)
        WIDTH_PARAMETER_ID = 3
        HEIGHT_PARAMETER_ID = 4
        open_cv_camera.set(WIDTH_PARAMETER_ID, camera_width)
        open_cv_camera.set(HEIGHT_PARAMETER_ID, camera_height)
        camera = CameraService(open_cv_camera, cv2)
    if camera_config == "mock":
        camera = MockCameraService(image_path='vision_utils/embedded_treasures.jpg')
    return camera

if __name__ == '__main__':
    config = configuration.get_config()

    host = config.get('robot', 'host')
    port = config.getint('robot', 'port')
    wheels_config = config.get('robot', 'wheels')
    base_station_host = config.get('baseapp', 'host')
    base_station_port = config.get('baseapp', 'port')
    camera_height = config.getint('baseapp', 'camera_height')
    camera_width = config.getint('baseapp', 'camera_width')
    embedded_camera = config.get('robot', 'camera')
    embedded_camera_id = config.getint('robot', 'camera_id')
    base_station_address = "http://" + base_station_host + ":" + base_station_port
    island_server_address = config.get('island_server', 'host')
    loop_time = config.getfloat('robot', 'loop-time')
    min_distance_to_destination = config.getfloat('robot', 'min-distance-to-destination')

    camera = camera_builder(embedded_camera, embedded_camera_id, camera_width, camera_height)
    robot_service = RobotService(island_server_address)

    world_map_service = WorldmapService(base_station_host, base_station_port)
    table_calibration_service = TableCalibrationService(base_station_host, base_station_port)
    table_corners = table_calibration_service.get_table_corners()
    pixel_per_meters = table_calibration_service.get_pixel_per_meter_ratio()

    if wheels_config == "simulation":
        world_map = SimulationMap(1600, 1200, world_map_service, table_calibration_service)
        try:
            refresh_time = config.getint('robot', 'wheels-refresh-time')
        except:
            print("Warning : wheels-refresh-time not specified, setting 10")
            refresh_time = 10

        try:
            wheels_velocity = config.getint('robot', 'wheels-velocity')
        except:
            print("Warning : wheels-velocity not specified, setting 5")
            wheels_velocity = 5

        try:
            noise = config.getint('robot', 'simulation-noise')
        except:
            print("Warning : noise not specified, setting 0")
            noise = 0

        wheels = NoisyWheels(world_map, refresh_time=refresh_time, wheels_velocity=wheels_velocity, noise=noise)
        corrected_wheels = WheelsCorrectionLayer(wheels, 1.0)
        manchester_antenna = ManchesterAntennaSimulation()
        battery = BatterySimulation()
        magnet = MagnetSimulation()
        robot_service = RobotServiceSimulation()
        camera_rotation = Mock()

    elif wheels_config == "usb-arduino":

        assembler = RobotInfoAssembler()
        vision_daemon = VisionDaemon(base_station_address, assembler)
        camera_position_x = config.getint('robot', 'camera-position-x')
        camera_position_y = config.getint('robot', 'camera-position-y')
        camera_height = config.getfloat('robot', 'camera-height')
        robot_height = config.getfloat('robot', 'robot-height')
        vision_perspective_corrected= VisionPerspectiveCorrection(vision_daemon, Position(camera_position_x,camera_position_y), camera_height, robot_height)
        world_map = Map(vision_perspective_corrected, world_map_service, table_calibration_service)

        arduino_pid = config.getint('robot', 'arduino-pid')
        arduino_vid = config.getint('robot', 'arduino-vid')
        polulu_pid = config.getint('robot', 'polulu-pid')
        polulu_vid = config.getint('robot', 'polulu-vid')
        arduino_baudrate = config.getint('robot', 'arduino-baudrate')
        ports = lp.comports()
        arduino_port = list(filter(lambda port: port.pid == arduino_pid and port.vid == arduino_vid, ports))
        polulu_port = list(filter(lambda port: port.pid == polulu_pid and port.vid == polulu_vid, ports))
        polulu_port_hardcoded = '/dev/ttyACM0'
        assert(len(list(arduino_port)) != 0)
        assert(len(list(polulu_port)) != 0)
        real_polulu_port = min(map(lambda x: x.device, polulu_port))
        polulu_serial_port = serial.Serial(port=real_polulu_port)
        arduino_serial_port = serial.Serial(port=arduino_port[0].device, baudrate=arduino_baudrate, timeout=1)

        wheels = WheelsUsbController(arduino_serial_port, WheelsUsbCommands())
        corrected_wheels = WheelsCorrectionLayer(wheels, pixel_per_meters)
        manchester_antenna = ManchesterAntennaUsbController(arduino_serial_port)
        battery = Battery(arduino_serial_port)
        prehenseur = PrehenseurRotationControl(polulu_serial_port)
        magnet = Magnet(arduino_serial_port, prehenseur)
        robot_service = RobotService(island_server_address)
        camera_rotation = CameraRotationControl(polulu_serial_port)

    movement = Movement(compute=None, sense=world_map, control=wheels, loop_time=loop_time, min_distance_to_destination=min_distance_to_destination)
    robot = Robot(wheels=corrected_wheels, world_map=world_map, pathfinder=None,
                  manchester_antenna=manchester_antenna, movement=movement, battery=battery, magnet=magnet, camera_rotation = camera_rotation)
    robot.lift_prehenseur_up()
    time.sleep(1)
    robot.lift_prehenseur_down()
    treasure_easiest_path = TreasureEasiestPath()
    vision_refresher = VisionRefresher(robot, base_station_host, base_station_port, camera, table_corners, treasure_easiest_path)
    action_machine = ActionMachine()
    embedded_vision_service = EmbeddedVisionService(
        camera,
        EmbeddedTreasureDetector(),
        EmbeddedRechargeStationDetector())

    timer = Timer()
    context = Context(robot, robot_service, world_map, embedded_vision_service, action_machine, treasure_easiest_path, timer, vision_refresher)
    start_timer = StartTimerAction(context, "start_timer_done")
    refresh_image = RefreshImageAction(context, "refresh_image_done")
    move_to_charge_station = MoveToChargeStationAction(context, 'move_to_charge_station_done')
    pick_up_treasure = PickUpTreasureAction(context, 'pick_up_treasure_done')
    drop_down_treasure = DropDownTreasure(context, 'drop_down_treasure_done')
    discover_manchester_code = DiscoverManchesterCodeAction(context, 'discover_manchester_code_done')
    find_island_clue = FindIslandClue(context, 'find_island_clue_done')
    recharge = RechargeAction(context, 'recharge_done')
    find_best_treasure = FindBestTreasureAction(context, 'find_best_treasure_done')
    find_island = FindIslandAction(context, 'find_island_done')
    move_to_target_island = MoveToTargetIslandAction(context, 'move_to_target_island_done')
    end_action = EndSequenceAction(context, None)

    scan_treasure = ScanTreasuresAction(context, 'scan_treasures_done')
    align_charging_station = AlignWithChargingStationAction(context, 'align_charging_station_done')
    align_treasure = AlignWithTreasureAction(context, 'align_treasure_done')
    move_to_treasure = MoveToTreasureAction(context, 'move_to_treasure_done')
    refresh_map_second_time = RefreshImageAction(context, 'second_refresh_done')

    action_machine.register("second_refresh", refresh_map_second_time)
    action_machine.register("start_timer", start_timer)
    action_machine.register("refresh_image", refresh_image)
    action_machine.register('move_to_charge_station', move_to_charge_station)
    action_machine.register('discover_manchester_code', discover_manchester_code)
    action_machine.register('pick_up_treasure', pick_up_treasure)
    action_machine.register('end_action', end_action)
    action_machine.register('drop_down_treasure', drop_down_treasure)
    action_machine.register('find_island_clue', find_island_clue)
    action_machine.register('recharge', recharge)
    action_machine.register('move_to_target_island', move_to_target_island)
    action_machine.register('move_to_treasure', move_to_treasure)
    action_machine.register('find_island', find_island)
    action_machine.register('find_best_treasure', find_best_treasure)
    action_machine.register('align_charging_station', align_charging_station)
    action_machine.register('align_treasure', align_treasure)
    action_machine.register("scan_treasures", scan_treasure)

    action_machine.bind("start_timer", "start_timer")
    action_machine.bind("refresh_image", "refresh_image")
    action_machine.bind('move_to_charge_station', 'move_to_charge_station')
    action_machine.bind('align_charging_station', 'align_charging_station')
    action_machine.bind('find_island', 'find_island')
    action_machine.bind('move_to_treasure', 'move_to_treasure')
    action_machine.bind('move_to_target_island', 'move_to_target_island')
    action_machine.bind('find_best_treasure', 'find_best_treasure')
    action_machine.bind('pick_up_treasure', 'pick_up_treasure')
    action_machine.bind('drop_down_treasure', 'drop_down_treasure')
    action_machine.bind("read_manchester", "discover_manchester_code")
    action_machine.bind('find_island_clue', 'find_island_clue')
    action_machine.bind("recharge", "recharge")
    action_machine.bind("scan_treasures", "scan_treasures")
    action_machine.bind('align_treasure', 'align_treasure')
    action_machine.bind("second_refresh", "second_refresh")

    action_machine.bind('start', 'start_timer')
    action_machine.bind("start_timer_done", "refresh_image")
    action_machine.bind('refresh_image_done', 'move_to_charge_station')
    action_machine.bind('move_to_charge_station_done', 'align_charging_station')
    action_machine.bind('align_charging_station_done', 'second_refresh')
    action_machine.bind('second_refresh_done', 'recharge')
    action_machine.bind('recharge_done', 'discover_manchester_code')
    action_machine.bind('discover_manchester_code_done', 'find_island_clue')
    action_machine.bind('find_island_clue_done', 'find_island')
    action_machine.bind('find_island_done', 'find_best_treasure')
    action_machine.bind('find_best_treasure_done', 'move_to_treasure')
    action_machine.bind('move_to_treasure_done', 'align_treasure')
    action_machine.bind('align_treasure_done', 'pick_up_treasure')
    action_machine.bind('pick_up_treasure_done', 'move_to_target_island')
    action_machine.bind('move_to_target_island_done', 'drop_down_treasure')
    action_machine.bind('drop_down_treasure_done', 'end_action')
    action_machine.bind('stop', 'end_action')

    robot_web_controller.inject(robot, vision_refresher, robot_service, action_machine, timer)
    robot_web_controller.run(host, port)
