camillebeland/design3/project.cfg

[robot]
#host = localhost
host = 192.168.0.34
#host = 192.168.1.41
port = 3000
#wheels = simulation
#wheels-refresh-time = 10
#wheels-velocity = 50
#simulation-noise = 0
wheels = usb-arduino
arduino-pid = 66
arduino-vid = 9025
polulu-pid = 137
polulu-vid = 8187
arduino-baudrate = 115200
loop-time = 0.25
min-distance-to-destination = 10.0
camera-position-x = 800
camera-position-y = 600
camera-height = 200
robot-height = 25
camera = webcam
camera_id = 0

[webapp]
host = 192.168.0.35
#host = 192.168.1.39
#host = 10.248.77.243
port = 8080

[baseapp]
host = 192.168.0.35
#host = 10.248.77.243
#host = 192.168.1.39
#host = 10.248.200.236
port = 5000
camera = webcam
camera_id = 1
refresh_time = 0.1
camera_width = 1600
camera_height = 1200

[island_server]
#host = https://132.203.14.228/
host = https://192.168.0.2/
#host = https://192.168.1.2/
