camillebeland/design3/Arduino/test/Transmitter/manchester_transmitter.h

#ifndef manchester_transmitter_h
#define manchester_transmitter_h


#define BAUD_RATE 600

// -------------SETUP ----------------
void manchester_transmitter_init();


//-------------------------------------


int manchester_transmitter_send(int * ptr);

// ----------------ISR ----------------



#endif // serial_h
