camillebeland/design3/Arduino/test/main/CircularBuffer.cpp

#include "CircularBuffer.h"
#include <stdio.h>
#include <string.h>

CircularBuffer::CircularBuffer(int size){
	buffer = new int[size];
	memset(buffer, 0, size*sizeof(int*)); 
	readIndex = 0;
	writeIndex = 0;
	bufferSize = size;
}

CircularBuffer::CircularBuffer(CircularBuffer& copy){
	buffer = new int[copy.bufferSize];
	copy.read(buffer);
	readIndex = 0;
	writeIndex = 0;
	bufferSize = copy.bufferSize;
	
}

void CircularBuffer::write(int data){
	buffer[writeIndex] = data;
	writeIndex = (writeIndex+1)%bufferSize;
}

void CircularBuffer::read(int* ptr){
	memcpy(ptr, buffer, bufferSize*sizeof(int));
}

int CircularBuffer::read(){
	int toReturn = buffer[readIndex];
	readIndex = (readIndex+1)%bufferSize;
	return toReturn;
}

CircularBuffer::~CircularBuffer(){
	delete[] buffer;
}
