camillebeland/design3/(commit log)

2016-01-16 Ajout des fichiers de description du projet
2016-01-16 Ajout dun environnement de base
2016-01-17 correction des apostrophes dans la description du projet
2016-01-17 Modèle de rapport!
    Allez dans Rapport.tex afin d'ajouter vos nom etc...
2016-01-18 Jai enlever wheel des requirements puisque pour linstant on sait pas trop ce que ca fait
2016-01-18 retrait de certain fichier de compilation et ajout du gitignore pour les fichier de compilation latex
2016-01-19 Suppression des documents de description. Ils vont dans le google drive.
2016-01-20 ébauche de librairie pour le contrôle des moteurs
2016-01-20 librairie moteur
    -fonction MOVE avec direction (avant, arriere, gauche, droite)
    -Asservissement en vitesse configurable
    -Gestion de la lecture de la position des roues
2016-01-21 Ajout dune classe et des tests non fonctionnels sur le robot
2016-01-21 Ajout des tests FONCTIONNELS et retrait des tests bidons
2016-01-21 librairie moteur
    - ajout de controle individuel sur chaque roue
    - fonctions cumulatives -> move_straight à droite et move_straight en
    haut = diagonale
    - fonction move de facon pseudo interrupt (peut faire autre chose
    pendant que le robot bouge)
    - fonctions stop et reset
    [main.ino, motors.cpp, motors.h]
2016-01-22 Ajout de la vitesse au robot
2016-01-22 Ajout de la fonction move(angle, speed)
2016-01-22 Librairie Moteur
    - Après lecture de la data sheet du pont en H, ajout des pins manquantes
    et légères modifs pour compatibilité
2016-01-22 Librarie électro-aimamt
    + lecture du voltage du condensateur
2016-01-25 ajout de mon nom sur la page titres, désolé pour les autres, je ne connais pas vos matriules
2016-01-25 Librairie moteur
    cleaning up + j'ai mis des long à place des int pour plus de précision
2016-01-26 Corrections suites aux test du 25 janvier
    [decoder.cpp, decoder.h, main.ino, motors.cpp, motors.h, serial.cpp, serial.h]
2016-01-27 Petit refactor, on enleve src et on met directement les packages dans la racine. Le fichier .gitignore est modifié en conséquence Les tests ont recu un setup et un teardown
2016-01-28 Descriptions des exigences
2016-01-28 librairie moteur
    -MOAR modularity
    -fonctions stop/resume
    -pinout pour tous les moteurs sur le mega
2016-01-28 Description de la DPF
2016-01-28 Ajout d'un fichier pour le texte des expérience préliminaire
2016-01-29 Modifié les formats d'encodage du fichier experience_preliminaire. Il faut s'assurer d'être en IsoLatin1 ou latin1 pour que les accents affichent correctement. Ajout des diagrammes de classe et de sé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
2016-01-29 updated experience preliminaire sur la recherche de chemin
2016-01-29 Ajout de mes expérimentations dans le rapport
2016-01-29 ajout des expérimentation glo
2016-01-30 Ajout des cas d'utilisations
2016-01-30 Ajout-MatLev
    Ajout de la section sur l'électroaimant/code manchester
2016-01-31 ajout de la dpf en annexe, correction de quelques fautes et rotation de quelques pages en paysage
2016-01-31 ajout du diagramme de contexte + rename annexe1
2016-01-31 remplacement de *.pdf par Rapport.pdf du gitignore
2016-02-01 Changer DPF pour le bon mot et les graphiques
2016-02-02 Librarie moteur + décodeur
    résultat après les expériences dans la nuit du 1er fev au 2 fev
2016-02-03 ajout d'un brake dans le PID
2016-02-03 Petit remaniement des fichiers
    [project.cfg]
2016-02-03 rearrange port numbers
    [project.cfg]
2016-02-04 Jai setter les deux sockets, maintenant je crois quil y a un probleme de headers...
2016-02-04 limit integrator output (overshoot)
    [decoder.cpp, motors.cpp]
2016-02-04 Revert "Jai setter les deux sockets, maintenant je crois quil y a un probleme de headers..."
    This reverts commit 912e6b35eafdd8a862711727b29c8812da492ab1.
2016-02-04 shits fixed we got four wheeeeels BOYS
    [decoder.cpp, main.ino, motors.cpp, motors.h]
2016-02-04 split socket for robot and image
2016-02-05 retrait de la logique du robot_app.py pour le mettre dans le robot_web_controller
2016-02-05 Ajout de la classe robot Modification de la classe MockRobot pour MockWheels Modification de la fonction set_vel pour set_velocity Modification du fichier config pour specifier quel wheels utiliser
    [project.cfg]
2016-02-05 refactor socket constant
2016-02-05 camera taking pictures
2016-02-06 retrait des fichier idea du git.
2016-02-06 Modifer quelques tests desuets et plugger le set-velocity du robot
2016-02-06 change from socket to get and optimise call to go fastest as possible without freezing browser
2016-02-07 fonctionne, sauf que le clean code est douteux. Je vais essayer de cleaner ca
2016-02-07 petit refactor, web_app.py est juste un main de config et la logique de server http est dans webapp/server.py
2016-02-07 add mock for camera_service
    [project.cfg]
2016-02-07 Modification des constante de rafraichissement
2016-02-07 Ajout des fonctions rotate_left, rotate_right, move_slow, move_default
2016-02-08 Ajout de la map : En gros le robot contient des roues et une map. Les roues agissent sur le robot dans la map. Les roues ne connaisse pas la direction du robot et ne peuvent que se deplacer ou faire 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
    [project.cfg]
2016-02-08 Ajout de tests pour les roues et la map
2016-02-08 Motors + decoder optimisation + bug fixed
    [decoder.cpp, decoder.h, motors.cpp, motors.h]
2016-02-08 Decoder
    - Whenever "(" is detected, the decoder resets as if it is the first '('
    it received and it is now ready to receive the function byte
    [decoder.cpp, magnet.cpp, magnet.h]
2016-02-09 Fixes following robot's first walk ever
    [TimerFour.cpp, decoder.cpp, decoder.h, motors.cpp, motors.h]
2016-02-09 add thread to read all frames
    [project.cfg]
2016-02-09 Ajout des roues avec communication usb
    [project.cfg]
2016-02-09 Fix pour le décodeur
    - maintenant les valeurs >= 128 devraient fonctionner !
    [decoder.cpp, decoder.h]
2016-02-10 Ajout des limites aux commandes usb : On ne peut envoyer d'angle > 180 Les nombres negatifs sont traduit en nombre positif
2016-02-10 modification du fichier config pour acceuillir la possibilite de brancher le robot par usb
2016-02-11 refactor camera_service
2016-02-11 ajout control camera python
2016-02-11 Added robot angle to socket
2016-02-12 essaie de config
    [project.cfg]
2016-02-12 test for image web controller
    [project.cfg]
2016-02-12 Ajout de précision en vitesse
    - cast en int à la fin seulement
2016-02-12 vidéo dans le canvas. Reste a setter la bonne taille avec la vraie caméra demain
2016-02-12 Fixed y axis bug.
2016-02-12 strop thread in delete
2016-02-13 Un debut de path finding
2016-02-13 add camera size in config
    [project.cfg]
2016-02-14 added capped output for motors
2016-02-17 On peut afficher un mesh Issue : il faut afficher le mesh par dessus de limage
2016-02-17 Modification du vid/pid du arduino
    [project.cfg]
2016-02-18 Ajout des hosts pour les servers
    [project.cfg]
2016-02-18 Refactor de la vision
2016-02-18 Voici des cofigs qui marche, reste les negatifs,
    [project.cfg]
2016-02-18 fixed les negatif for real à partir du decodeur
    [decoder.cpp, decoder.h, magnet.cpp, magnet.h, main.ino, motors.cpp, motors.h, serial.h]
2016-02-19 On a regler les tests et la communication seriel entre le minipc et le arduino
    [project.cfg]
2016-02-21 Multi-threaded base_station_app in order to use it's REST API while getting camera stream from multipart GET.
2016-02-22 modification de tests/robot modification de linit de la camera
2016-02-22 Retrait des fichier/classe inutiles
2016-02-23 Ajout de lerreur sur la simulation correction dune erreur dindentation
    [robot_app.py]
2016-02-23 add camera and area
    [project.cfg]
2016-02-23 Manchester avec timer custom, à tester.....
2016-02-24 Fixed le manchester + asservissement maintenant à 20 HZ just for lolz
    [TimerOne.cpp, TimerOne.h, Transmitter.ino, decoder.cpp, main.ino, manchester.h, motors.cpp, motors.h]
2016-02-24 Un bon debut de refactor
2016-02-27 ajout de la dpf dans le rapport
2016-02-28 Update DPF.tex
    ajout de subsection pour le paragraphe prochaine action
2016-02-28 Mis à jour le rapport avec des nouvelles dates et les nouveax diagrammes. Sont pas encore top shape mais ça fait la job.
2016-02-28 refactor de Movement
2016-02-28 Changé un import de robot a movement
2016-02-28 ajout de tests pour le robot
2016-02-28 ajout des textes de GEL pour l'avancement
2016-02-28 la fonction find_polygon_contour renvoie maintenant une liste dobjet avec {x,y}
2016-02-28 ajout des textes d'introduction et figure du registre de risques (a updater)
2016-02-29 Ajout de diagrammes manquants et correction de diagrammes existants
2016-02-29 change map dimensions
    [project.cfg]
2016-03-01 Fixed le timeout du serial pour qui bug JAMAIS
    [TimerOne.cpp, TimerOne.h, decoder.cpp, decoder.h]
2016-03-05 python to python sockets working! ...not at the same time as base_station.py :(
2016-03-05 Revert "python to python sockets working! ...not at the same time as base_station.py :("
    This reverts commit 299fd024784e3b97eb35b601706fe5730b1506ca.
    [base_station_app.py, robot_app.py]
2016-03-05 Wireless Serial 1.0 RX AND TX
    - à tester, tester, tester.....
2016-03-06 mesh a partir de la vision, mais inversé dans le ui
2016-03-07 Ground control to major tom
2016-03-07 Modification de requirements Modification de la taille de la cellule principale dans le mesh
2016-03-07 Pas mal toute solver les problemes
    [project.cfg]
2016-03-07 Fixed the world
    [project.cfg]
2016-03-08 finds all islands (every color) and resize to fit camera
    [project.cfg]
2016-03-08 Comm série continued
    -% de la batterie avec (b)
    -% de la charge des condensateur avec (v)
    - code manchester avec (c)
    - Préparation pour les tests avec la librarie virtualWire pour améliorer
    la fiabilté du transfert du code manchester
    [project.cfg]
2016-03-09 virtual wire workin
    [project.cfg]
2016-03-11 battery level identifié
2016-03-15 added vision REMI NEED REFACTOR INTENSE
    [project.cfg]
2016-03-15 Robot can call island server
    [project.cfg]
2016-03-15 Revert "added vision REMI NEED REFACTOR INTENSE"
    This reverts commit 51b6a0cce9b900bd50c54daeb794c3cafc503c10.
    [project.cfg]
2016-03-15 Modification de launch pour faire un wait apres avoir demarrer le base station Retrait du print dans islands_service.py la map ne tire plus d'exception si le robot est en dehors de la frontiere
2016-03-15 Le test qui testait a savoir si une exception était levée lorsque le robot sortait de la map est détruit
2016-03-15 Call to arduino
2016-03-16 added a web_service on robot to call island server. setup island server to eduroam
    [project.cfg]
2016-03-16 fixed pour asservissement "parfait"
    [motors.cpp, motors.h]
2016-03-16 On ajoute des carré autour de la map
2016-03-16 find purple circle and square
    [project.cfg]
2016-03-16 get robot position and error handling for islands
    [project.cfg]
2016-03-17 refactor et ajout de la classe prehenseur_camera_control. peut potentiellement etre rassemblé dans une seule classe, MaestroControl
2016-03-17 revert the bug fix because it block the entire app. must be on another thread
2016-03-17 Backend call to Arduino to get indicators done.
2016-03-17 Ajout de l'action move_to_charge station
2016-03-17 La classe polygon est maintenant dans le fichier polygon, probleme d'import
    [robot_app.py]
2016-03-17 Fixed islands service construit bien les iles dans une map vide
2016-03-18 quick fix
    fix le petit "stutter" qu'il y avait à chaque nouvelle commande de
    mouvement (les intégateurs étaient reset à chaque nouvelle commande)
    [motors.cpp]
2016-03-18 on s'assure d'avoir les îles avant de créer le mesh
2016-03-18 fetch continu de la position du robot dans un thread + test
2016-03-18 début pour david
    [project.cfg]
2016-03-19 UI can decide to show the robot's position according to the world camera but it's a separate process from the "real" robot position.
    [project.cfg]
2016-03-19 remove print
2016-03-19 Ajout d'un POST sur le robot a l'url : robot:port/action/<action_name> Il y a une action qui est implémenté cest start, le robot va a la station de recharge
2016-03-19 Changement de l'url pour :actions/<action_name> Ajout d'une méthode GET sur /actions pour énumérer les actions possibles. la clé du dictionnaire est l'event qu'on doit appeler et la valeur est l'acti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
2016-03-20 rajout du input pour la batterie
2016-03-20 Ajout d'une premiere ébauche des actions
2016-03-20 Changé les membres privés pour membres protégés des Actions.
2016-03-21 Ajout d'un decorateur pour le robot qui log toutes les commands envoyé au robot, sauf les get (pour l'instant) Le movement est injecté a la création au robot
2016-03-21 update des constantes selon le prehenseur
2016-03-22 fix angle and position in ui
    [project.cfg]
2016-03-22 algo ratio marche, pas intégré
    [project.cfg]
2016-03-22 mesh with contours
    [project.cfg]
2016-03-23 bug solving
    [project.cfg]
2016-03-23 extracted battery from manchester_antenna
2016-03-23 Extracted mechanical gripper from the manchester_antenna
2016-03-24 ajout des points mort individuels pour les roues
2016-03-24 refactor vision service tests to be integration
    [project.cfg]
2016-03-24 filter islands
2016-03-24 add test and error handling
    [robot_app.py]
2016-03-24 various improvement
    -ajout du PWM pin 13 du Arduino pour base_station
    -ajout des fonction pour activer la recharge/desactiver
    -modif du voltage "full" pour les condensateurs
2016-03-24 Wheels correction layer
2016-03-24 trying to make tests
    [project.cfg]
2016-03-24 Finished corrections but abandoned unit tests considering project's context
    [robot_app.py]
2016-03-25 lab debug
    [project.cfg]
2016-03-25 vision plus robuste
    [project.cfg]
2016-03-26 added a simulation test config file
    [simulation_project.cfg]
2016-03-26 Fixed some bugs
    [project.cfg]
2016-03-26 Fixed the batteries robot_app is not rotating anymore
    [robot_app.py]
2016-03-26 Fix for gripper.
2016-03-27 simulation moving fixed
    [simulation_project.cfg]
2016-03-27 Solved path problem
    [project.cfg]
2016-03-27 Fixed buttons not responding in UI. Minor UI changes. Added stop button.
2016-03-27 fix des diago qui marchait pas avec atan2
    [Transmitter.ino, decoder.cpp, magnet.h, motors.cpp, motors.h]
2016-03-28 Changement de certains paramètres
    [project.cfg]
2016-03-28 charging station detector
2016-03-28 ajout de min speed
2016-03-28 add charging station in ui
2016-03-29 fix when no position
    [simulation_project.cfg]
2016-03-29 charging station vision
2016-03-29 work by adam march 29
    [project.cfg]
2016-03-29 robot working as expected with the current known bugs
    [project.cfg]
2016-03-29 converted voltage shown in UI to be in Volts instead of percentage.
2016-03-29 minor corrections to check Pull request
    [simulation_project.cfg]
2016-03-29 Implementation du magnet et du maestro
2016-03-30 Ajout de la fonction recharge
2016-03-30 good config
    [project.cfg]
2016-03-30 Fixed it, il reste a blocker le move_to et le rotate
2016-03-30 ui actions + fine tune buttons
2016-03-30 On peut maintenant avoir l'island clue dans le UI soit : Faire un post au robot directement à /island/<clue> Soit envoyer une action du robot avec find_island_clue lorsqu'il y a un code manchester va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
2016-03-30 Ajout de l'action dans le robot
2016-03-31 La fonction move_to du robot a maintenant un callback qu'il apelle lorsquil est arrivé
2016-04-01 Leger refactor de certaines fonctions mathematique dans la map et la simulation map Implementation de la correction de la perspective de la vision On doit entrer dans le fichier config la position de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
    [simulation_project.cfg]
2016-04-01 Ajout des parametres de perspective
    [project.cfg]
2016-04-01 Il y a maintenant 4 rectangles représentant les bordures de la table
2016-04-01 Début....
    -map treasure() donne les coordonnées en X de la détection des trésor
    sur les mur noirs
2016-04-02 Ajout de mes parties updated
2016-04-02 On peut maintenant lancer une commande au robot par un POST a: host:port/robot/vision/refresh Il ne reste plus que la base station recalcule de son cote les calibrations a lapel de refresh
2016-04-02 update sequence diagrams
    [project.cfg]
2016-04-03 clean up des .tex non nécéssaire à la remsie 3
2016-04-03 ajout de deux textes sur l'electronique
2016-04-03 ajout des trucs a JC plus reformattage
2016-04-03 Ajout d'un callback a recharge de sorte que la recharge se fasse sur un thread différent. le gripper est refactoré a l'intérieur du magnet
2016-04-03 Fixed launch in simulation and deleted bad unittest
    [robot_app.py]
2016-04-03 ajout section gantt et section electronique de math
2016-04-03 update registre de risques
2016-04-03 recover de vision qui était tout scrap :(
2016-04-03 ajout section de maxime
2016-04-03 petites précision sur asservissement des moteurs
2016-04-03 update texte diagrammes ainsi que ajustement échelle diagramme de classe
2016-04-03 correccion de frances
2016-04-04 Il y avait des restant de code du gripper dans magnet
2016-04-04 divers fixes
    - map treasure retourne une lsite d'angle
    - track treasure "fonctionne"
2016-04-04 Modification des parametres
    [project.cfg]
2016-04-04 button in ui
2016-04-04 TRACK ALL THE THINGS
2016-04-05 function to compute treasure positions and injections
    [simulation_project.cfg]
2016-04-05 On a une sequence de jeu !
    [simulation_project.cfg]
2016-04-06 add scan treasures action
    [simulation_project.cfg]
2016-04-07 printed any exception on robot web controller.
2016-04-08 Le robot trouve maintenant le tresor avec le moins de cellule a traverser.
2016-04-08 bug fix... les fonction avec param contenant "(" ou ")" étaient jamais call
    [decoder.cpp]
2016-04-09 On detecte le serial port du polulu quelques fixs sur map
    [project.cfg]
2016-04-09 Solved type arguments in wrong numbers fixed David
    [robot_app.py]
2016-04-09 On change le point de la charging station detector
2016-04-09 prod fix
    [project.cfg]
2016-04-09 Hot fix du pathfinding, devrait pu jamais pu trouver de path.. hope so.
2016-04-10 remove debug print
2016-04-10 added filter for treasures in the middle of the map in the vision.
2016-04-10 fix ui for island display
    [robot_app.py]
2016-04-10 Dont shutdown server because function doesnt work in our case. Now just closes serial connection
2016-04-11 Timer in UI.
2016-04-13 robot height a change a 25
    [project.cfg]
2016-04-13 Il stop quand il perd la connection
2016-04-13 quick fix
    - update du move distance à 0 jamais fait ( était après le continue)
    - < pour des <= (on peut être coincé la longtemps)
    - compute cas où on est pile dessus target_x is marker_position_X
2016-04-13 Backend implemented and linked. Should work
    [project.cfg]
2016-04-13 Bigger button!
2016-04-13 filter treasures near charging station
2016-04-14 Revert and deleted the has started led because was not showing right data when refreshing UI.
2016-04-14 fixed bugs live
    [project.cfg]
2016-04-14 Last minute changes
    [project.cfg]
2016-04-16 Added a test for timer
2016-04-17 description de la vision de la caméra embarquée
